IE-TDD-EL3313/Proyecto_1/docs/informe/informe_tecnico.md

# Informe técnico: Whack-a-Mole con lógica discreta y FPGA

## Resumen
Este proyecto presenta el diseño e implementación de un juego electrónico Whack-a-Mole mediante la integración de lógica discreta y una FPGA Nexys 4. El subsistema discreto, construido con integrados de la familia 74LS, utiliza un registro de desplazamiento con realimentación lineal (LFSR) para generar la posición pseudoaleatoria del topo y un decodificador 74LS138 para representarla en uno de ocho LEDs. La FPGA concentra el control del juego mediante una arquitectura modular desarrollada en SystemVerilog, incluyendo sincronización y antirrebote de ocho botones externos, temporización de los turnos, evaluación de golpes, dificultad progresiva, conteo de aciertos y fallos, control de vidas y visualización en displays de siete segmentos.
Aunque el planteamiento original especificaba una comunicación UART 8N1, las dificultades encontradas durante su integración llevaron a implementar temporalmente un enlace paralelo de tres bits para transmitir la posición. Las diferencias de voltaje entre ambos subsistemas se resolvieron mediante divisores resistivos y un transistor 2N2222 para la señal de solicitud. Los módulos de la FPGA fueron verificados mediante testbenches autoverificables, y la integración superó las pruebas de aciertos, fallos, timeout, dificultad, fin de partida y reinicio automático. La implementación demostró el funcionamiento general del juego, aunque se identificaron limitaciones en el LFSR discreto y en la confiabilidad de algunas solicitudes.

---

## 1. Introducción

### 1.1 Contexto

Whack-a-Mole es un juego en el que se activa aleatoriamente una de varias posiciones y el jugador debe presionar el botón correspondiente antes de que finalice un tiempo determinado. El proyecto solicita dividir el sistema en dos subsistemas: un circuito discreto encargado de generar y mostrar la posición pseudoaleatoria del topo, y una FPGA responsable del control de turnos, botones, puntajes, dificultad y visualización. La comunicación especificada originalmente entre ambos subsistemas corresponde a un enlace UART asíncrono 8N1.

### 1.2 Solución desarrollada

El circuito discreto utiliza un LFSR para generar una posición de tres bits y un 74LS138 para activar uno de ocho LEDs. La FPGA recibe la posición, solicita nuevos topos, filtra las señales de ocho botones externos y controla el juego mediante una máquina de estados. Además, implementa la ventana temporal, dificultad progresiva, conteo de aciertos y fallos, tres oportunidades consecutivas, estado de fin de partida y cuatro displays de siete segmentos.

### 1.3 Alcance y limitaciones
Se implementaron y verificaron completamente los módulos principales de control de la FPGA mediante testbenches autoverificables. Debido a problemas de estabilidad durante la integración UART, la posición se transmitió finalmente mediante el bus paralelo `Q[2:0]`. Esta modificación permitió obtener una integración funcional, pero no cumple el enlace serial solicitado originalmente. También se observaron bloqueos en ciertas posiciones del LFSR, especialmente en el estado 000, que requiere una semilla no nula o una corrección de la lógica de realimentación. Asimismo, algunas solicitudes no fueron reconocidas correctamente por el circuito discreto, por lo que se incorporaron mecanismos de diagnóstico y control de pulsos.

---

## 2. Objetivos

### 2.1 Objetivo general

Diseñar e implementar un juego Whack-a-Mole utilizando un subsistema de lógica discreta para generar la posición pseudoaleatoria y una FPGA Nexys 4 para controlar la dinámica del juego, las entradas del usuario, la temporización y la visualización de resultados.

### 2.2 Objetivos específicos

- Diseñar un generador pseudoaleatorio mediante un LFSR discreto.
- Decodificar la posición mediante un 74LS138.
- Generar una posición ante cada solicitud de la FPGA.
- Implementar ocho botones externos con sincronización y antirrebote.
- Controlar el juego mediante una máquina de estados finitos.
- Implementar dificultad progresiva entre 1500 ms y 500 ms.
- Contabilizar aciertos, fallos acumulados y fallos consecutivos.
- Mostrar los resultados en cuatro displays de siete segmentos.
- Implementar el estado de fin de partida y el reinicio.
- Verificar los módulos mediante testbenches autoverificables.
- Comparar los resultados teóricos, simulados y experimentales.

---

## 3. Especificaciones

### 3.1 Requisitos funcionales

La siguiente tabla compara los requisitos establecidos en el instructivo con la implementación final del sistema.

| Requisito | Valor especificado | Implementación final |
|---|---:|---|
| Posiciones del topo | 8 | Ocho posiciones codificadas mediante `Q[2:0]` y representadas en los LEDs `LD0–LD7` |
| Botones externos | 8 | Ocho pulsadores conectados al Pmod JB, sincronizados y filtrados contra rebotes |
| Tiempo inicial | 1500 ms | Ventana inicial de 1500 ms controlada por `turn_window_timer` |
| Reducción por acierto | 100 ms | Reducción de 100 ms después de cada acierto |
| Tiempo mínimo | 500 ms | Saturación de la ventana temporal en 500 ms |
| Fallos consecutivos | 3 | La partida termina después del tercer fallo consecutivo |
| Game over | 2000 ms | Estado de fin de partida durante 2000 ms, seguido de reinicio automático |
| Aciertos | 00–99 | Contador acumulado saturado en 99 y mostrado en dos dígitos |
| Fallos acumulados | 00–99 | Contador acumulado saturado en 99 y mostrado en dos dígitos |
| Reloj de la FPGA | 100 MHz | Reloj principal de 100 MHz de la Nexys 4 |
| Base temporal | 1 ms | Clock enable de un ciclo cada 100 000 ciclos de reloj |
| Indicador de estado | Partida activa/finalizada | `LD15` fijo durante la partida y parpadeante durante game over |
| Comunicación requerida | UART asíncrono 8N1 | Sustituida durante la integración por un enlace paralelo `Q[2:0]` |
| Solicitud de nuevo topo | Un pulso por turno | Pulso de 500 ms enviado por JA4 mediante un transistor 2N2222 |
| Reset general | Botón central | `BTNC` reinicia puntajes, fallos consecutivos, dificultad y secuencia de control |

La comunicación paralela fue utilizada debido a problemas de estabilidad encontrados durante la integración del enlace UART. Esta adaptación permitió verificar el funcionamiento del subsistema de control, pero representa una desviación respecto al protocolo exigido originalmente.

### 3.2 Requisitos eléctricos

El circuito discreto utiliza integrados de la familia 74LS alimentados con 5 V, mientras que las entradas y salidas Pmod de la Nexys 4 trabajan con lógica de 3.3 V. Por esta razón, fue necesario adaptar los niveles eléctricos entre ambos subsistemas.

- La lógica discreta se alimenta con una fuente regulada de 5 V.
- La FPGA utiliza niveles lógicos LVCMOS de 3.3 V.
- La FPGA y la protoboard comparten una misma referencia de tierra.
- Las señales `Q0`, `Q1` y `Q2` pasan por divisores resistivos antes de ingresar a JA1, JA2 y JA3.
- El voltaje aplicado a una entrada Pmod no debe superar 3.3 V.
- La señal discreta `SOLICITUD_TOPO` posee una resistencia pull-up de 10 kΩ hacia 5 V.
- `SOLICITUD_TOPO` es una señal activa en bajo.
- La salida JA4 no se conecta directamente al nodo de 5 V.
- Se utiliza un transistor NPN 2N2222 para aislar los niveles eléctricos e invertir la solicitud.

La conexión utilizada para generar la solicitud es:

```text
JA4 de la FPGA ── resistencia de 10 kΩ ── base del 2N2222
GND común ─────────────────────────────── emisor del 2N2222
SOLICITUD_TOPO ────────────────────────── colector del 2N2222
5 V ── resistencia pull-up de 10 kΩ ───── SOLICITUD_TOPO
```
---

## 4. Fundamentación teórica

### 4.1 Lógica combinacional y secuencial

Los sistemas digitales se construyen mediante lógica combinacional y lógica secuencial. En la lógica combinacional, las salidas dependen únicamente de las entradas presentes. Algunos ejemplos son las compuertas AND, OR, NOT y XOR, así como los multiplexores, comparadores y decodificadores.

En la lógica secuencial, las salidas también dependen del estado almacenado previamente. Los flip-flops permiten almacenar un bit, mientras que varios flip-flops conectados forman registros y contadores. En este proyecto se utilizan registros para almacenar los estados de la FSM, posiciones, puntajes, tiempos y niveles anteriores de los botones.

Toda la lógica secuencial de la FPGA trabaja con el reloj principal de 100 MHz de la Nexys 4. Para implementar eventos lentos no se generan relojes adicionales, sino una señal `ce_1ms` que habilita los registros una vez por milisegundo. Este enfoque mantiene un único dominio de reloj y facilita el análisis temporal.

El reset utilizado en los módulos es síncrono, ya que se evalúa dentro de bloques:

```systemverilog
always_ff @(posedge clk)
```

Los registros utilizan asignaciones no bloqueantes (`<=`), las cuales representan que todos los flip-flops actualizan sus salidas simultáneamente después del flanco activo del reloj. Por otra parte, la lógica combinacional se describe mediante `always_comb` y debe asignar valores en todos los caminos posibles para evitar la inferencia de latches no intencionados.

---

### 4.2 Linear Feedback Shift Register (LFSR)

Un Linear Feedback Shift Register es un registro de desplazamiento cuya entrada se calcula mediante una combinación XOR de algunos de sus bits internos. Los bits utilizados para calcular la realimentación reciben el nombre de *taps*.

En cada pulso de reloj, el contenido del registro se desplaza y el bit calculado mediante XOR se introduce en uno de sus extremos. Si se selecciona un polinomio primitivo, un LFSR de \(n\) bits puede producir una secuencia de periodo máximo:

\[
T_{\text{máximo}} = 2^n-1
\]

Para un LFSR de tres bits:

\[
T_{\text{máximo}} = 2^3-1 = 7
\]

Esto significa que un LFSR lineal convencional de tres bits puede recorrer como máximo siete estados no nulos antes de repetir la secuencia.

#### Polinomio utilizado

> **Importante:** sustituir esta expresión si los taps físicos utilizados por el equipo son diferentes.

Para una realimentación formada por `Q2 XOR Q1`, el polinomio puede representarse como:

\[
P(x)=x^3+x^2+1
\]

La ecuación de realimentación correspondiente es:

\[
f = Q_2 \oplus Q_1
\]

Suponiendo que el desplazamiento se realiza como:

```text
Q2_siguiente = Q1
Q1_siguiente = Q0
Q0_siguiente = Q2 XOR Q1
```

y que la semilla inicial es `001`, se obtiene la siguiente secuencia:

| Pulso | Estado actual | Realimentación `Q2 XOR Q1` | Estado siguiente | LED |
|---:|:---:|:---:|:---:|:---:|
| 0 | `001` | `0` | `010` | LED1 |
| 1 | `010` | `1` | `101` | LED2 |
| 2 | `101` | `1` | `011` | LED5 |
| 3 | `011` | `1` | `111` | LED3 |
| 4 | `111` | `0` | `110` | LED7 |
| 5 | `110` | `0` | `100` | LED6 |
| 6 | `100` | `1` | `001` | LED4 |

La tabla debe compararse con la secuencia medida en la protoboard. Si el orden real de desplazamiento o los taps son diferentes, debe modificarse para representar el circuito construido.

#### Estado absorbente `000`

El estado `000` es un estado prohibido para un LFSR basado únicamente en XOR. Si todos los bits son cero, la realimentación también será cero:

\[
0 \oplus 0 = 0
\]

Después del desplazamiento, el estado siguiente vuelve a ser `000`. Por lo tanto, el sistema queda bloqueado y no puede salir de ese estado mediante pulsos normales de reloj.

```text
Estado actual:    000
Realimentación:     0
Estado siguiente: 000
```

Por esta razón se utiliza un reset que carga una semilla diferente de cero, como `001`. Sin embargo, un LFSR de tres bits continúa teniendo solamente siete estados útiles. Para observar las ocho combinaciones en el 74LS138 sin utilizar un estado interno bloqueado, una alternativa consiste en implementar un LFSR de cuatro bits y utilizar tres de sus bits como posición visible.

---

### 4.3 Decodificador 74LS138

El 74LS138 es un decodificador de tres entradas y ocho salidas. Las entradas binarias A, B y C seleccionan una de las ocho salidas disponibles. El integrado también posee entradas de habilitación que deben colocarse en los niveles apropiados para activar su funcionamiento.

Las salidas del 74LS138 son activas en bajo. Esto significa que la salida seleccionada toma un valor cercano a 0 V, mientras que las demás permanecen en nivel alto. Los LEDs deben conectarse considerando que el integrado absorbe corriente cuando selecciona una posición.

| Q2 | Q1 | Q0 | Salida activa | Posición |
|:---:|:---:|:---:|---|---|
| 0 | 0 | 0 | Y0 | LED0 |
| 0 | 0 | 1 | Y1 | LED1 |
| 0 | 1 | 0 | Y2 | LED2 |
| 0 | 1 | 1 | Y3 | LED3 |
| 1 | 0 | 0 | Y4 | LED4 |
| 1 | 0 | 1 | Y5 | LED5 |
| 1 | 1 | 0 | Y6 | LED6 |
| 1 | 1 | 1 | Y7 | LED7 |

De esta manera, la palabra de tres bits generada por el LFSR se convierte en una representación one-hot, en la que solamente uno de los ocho LEDs se encuentra activo.

---

### 4.4 UART asíncrono

UART es un protocolo de comunicación serial asíncrono. Los dispositivos transmisor y receptor no comparten una señal de reloj, por lo que ambos deben utilizar una velocidad previamente acordada, denominada *baud rate*.

El formato solicitado para el proyecto fue UART 8N1:

- Un bit de inicio en nivel bajo.
- Ocho bits de datos.
- Sin bit de paridad.
- Un bit de parada en nivel alto.
- Transmisión del bit menos significativo primero.

```text
Reposo | START | D0 | D1 | D2 | D3 | D4 | D5 | D6 | D7 | STOP
   1   |   0   |             8 bits              |  1
```

La cantidad de ciclos del reloj de la FPGA contenidos en cada bit se calcula mediante:

\[
CLKS\_PER\_BIT =
\frac{CLK\_FREQ}{BAUD\_RATE}
\]

Para un reloj de 100 MHz y una velocidad de 2400 baudios:

\[
CLKS\_PER\_BIT =
\frac{100\,000\,000}{2400}
\approx 41666
\]

El receptor espera aproximadamente medio periodo después de detectar el bit de inicio. Esto permite comprobar el inicio cerca del centro del bit, donde la señal presenta mayor estabilidad. Posteriormente, cada bit de datos se muestrea una vez por periodo UART.

#### Módulo `uart_synchronizer`

La entrada UART proviene de un circuito con un reloj independiente, por lo que es asíncrona respecto al reloj de la FPGA. El módulo `uart_synchronizer` utiliza dos flip-flops en cascada:

```systemverilog
serial_meta <= serial_async;
serial_sync <= serial_meta;
```

La primera etapa puede experimentar metastabilidad. La segunda reduce la probabilidad de que ese estado se propague hacia la lógica del receptor. Después del reset, ambas etapas se inicializan en uno, correspondiente al estado de reposo de UART.

#### Módulo `uart_rx`

El módulo `uart_rx` implementa el receptor mediante una FSM con cuatro estados:

| Estado | Función |
|---|---|
| `IDLE` | Espera que la línea cambie de uno a cero |
| `START` | Espera medio bit y confirma el inicio |
| `DATA` | Captura los ocho bits, comenzando por D0 |
| `STOP` | Verifica el bit de parada y genera `data_valid` |

El parámetro `CLKS_PER_BIT` establece la cantidad de ciclos de 100 MHz por bit, mientras que `HALF_BIT` permite verificar el bit de inicio aproximadamente en su centro.

Los bits recibidos se almacenan mediante:

```systemverilog
rx_data[bit_index] <= serial_sync;
```

Al recibir correctamente el bit de parada, `data_valid` se activa durante un solo ciclo de reloj. Esto indica que `rx_data` contiene un byte completo y válido.

El receptor utiliza por defecto:

```systemverilog
CLK_FREQ  = 100_000_000
BAUD_RATE = 2400
```

Ambos valores son parametrizables.

#### Módulo `uart_test_led`

El módulo `uart_test_led` integra:

- Un sincronizador de dos etapas.
- Una instancia de `uart_rx`.
- Un decodificador de los tres bits menos significativos.
- Ocho LEDs de salida.

En esta prueba se configuró el receptor a 9600 baudios:

```systemverilog
uart_rx #(
    .CLK_FREQ  (100_000_000),
    .BAUD_RATE (9600)
)
```

Cuando `data_valid` se activa, los tres bits menos significativos se convierten a una representación one-hot:

```systemverilog
case (rx_data[2:0])
    3'd0: led <= 8'b00000001;
    3'd1: led <= 8'b00000010;
    3'd2: led <= 8'b00000100;
    3'd3: led <= 8'b00001000;
    3'd4: led <= 8'b00010000;
    3'd5: led <= 8'b00100000;
    3'd6: led <= 8'b01000000;
    3'd7: led <= 8'b10000000;
endcase
```

Esto permitió verificar que un byte UART podía transformarse en la posición correspondiente.

#### Resultado de simulación UART

La simulación integrada utilizó:

```text
Frecuencia de reloj: 100 MHz
Baud rate:           2400 baudios
Formato:             UART 8N1
CLKS_PER_BIT:        41666 ciclos
```

Durante la prueba se transmitieron los siguientes bytes:

| Byte transmitido | Bits menos significativos | Posición esperada | Resultado |
|---:|:---:|---:|---|
| `0x05` | `101` | 5 | Correcto |
| `0x03` | `011` | 3 | Correcto |
| `0x07` | `111` | 7 | Correcto |
| `0x00` | `000` | 0 | Correcto |

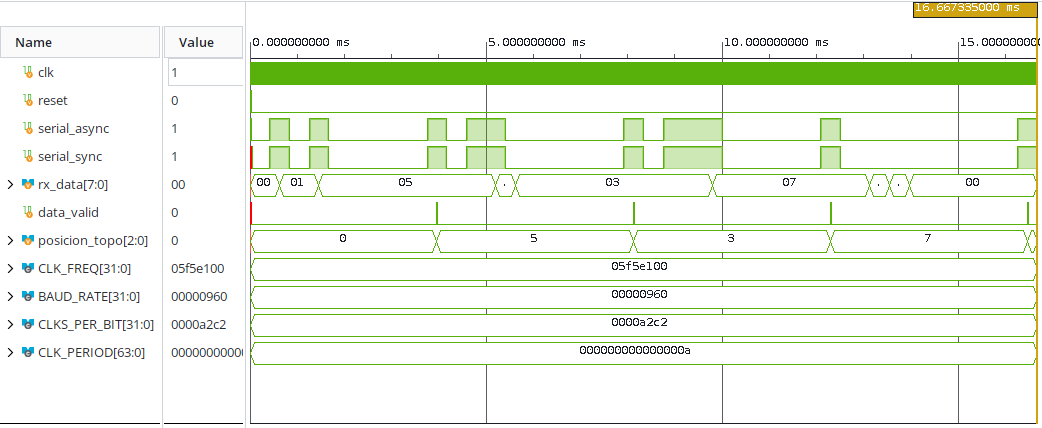
[picture p1: docs/informe/Imagenes/uart_integrado.png]
Simulación integrada del receptor UART


En la forma de onda se observa que `serial_async` contiene las tramas generadas por el testbench. La señal `serial_sync` reproduce la entrada después de atravesar el sincronizador de dos etapas.

Durante la recepción, `rx_data` cambia conforme se almacenan los bits. Por esta razón, su contenido solamente debe interpretarse cuando `data_valid` se activa. Después de cada trama válida, la posición registrada sigue la secuencia:

```text
0 → 5 → 3 → 7 → 0
```

El resultado demuestra que el sincronizador, la FSM del receptor, el registro de datos y la extracción de `rx_data[2:0]` funcionaron correctamente en simulación con señales UART ideales.

Durante la integración física se presentaron problemas de estabilidad relacionados con la generación discreta del baud rate y la comunicación entre dos relojes independientes. Por esta razón, la versión final utilizó temporalmente el bus paralelo `Q[2:0]`. La simulación se conserva como evidencia de que el receptor UART descrito en HDL funcionó bajo las condiciones temporales establecidas.

---

### 4.5 Comunicación paralela implementada

La integración final transmite la posición mediante tres señales independientes:

```text
Q0 → JA1
Q1 → JA2
Q2 → JA3
```

Estas señales representan directamente un valor binario entre cero y siete. Debido a que provienen de un circuito discreto de 5 V, se utilizan divisores resistivos para reducir su nivel antes de conectarlas a la FPGA.

Dentro de la FPGA, `Q[2:0]` atraviesa un sincronizador de dos etapas. Posteriormente, el módulo `parallel_position_receiver` exige que la palabra permanezca estable durante un tiempo configurable antes de aceptarla.

La salida `position_valid` se activa durante un ciclo cuando se acepta la primera posición o cuando se detecta una posición distinta de la anterior.

Las principales ventajas del enlace paralelo son:

- Menor complejidad de integración.
- No requiere recuperación de baud rate.
- Permite observar directamente la posición.
- Facilitó la verificación del control del juego.

Sus principales limitaciones son:

- Utiliza tres líneas en lugar de una.
- No corresponde al protocolo UART exigido.
- No contiene bits de inicio o parada.
- No diferencia dos recepciones consecutivas con el mismo valor sin una señal adicional de dato válido.
- La coherencia del bus depende del filtro de estabilidad.

---

### 4.6 Metastabilidad

La metastabilidad puede ocurrir cuando una entrada cambia muy cerca del flanco activo del reloj. En esta condición, un flip-flop puede tardar un tiempo indeterminado en establecer un cero o un uno válido.

Los botones, la entrada UART y las señales `Q0`, `Q1` y `Q2` son asíncronas respecto al reloj de 100 MHz. Para reducir el riesgo se utilizan dos flip-flops en cascada:

```text
Entrada asíncrona → primera etapa → segunda etapa → lógica interna
```

El sincronizador no elimina matemáticamente la metastabilidad, pero aumenta significativamente el tiempo disponible para que la primera etapa se estabilice antes de que la señal sea utilizada por el resto del diseño.

Para el bus paralelo, la sincronización se complementa con una validación temporal. Esto evita aceptar inmediatamente palabras transitorias causadas por diferencias en el tiempo de propagación de los tres bits.

---

### 4.7 Rebote de botones

Los contactos mecánicos de un pulsador no cambian una sola vez entre cero y uno. Durante algunos milisegundos pueden producir varias transiciones rápidas conocidas como rebote.

Sin un filtro, una sola pulsación podría interpretarse como múltiples golpes. El diseño realiza primero la sincronización de cada botón y después muestrea su nivel cada milisegundo.

Un nuevo estado solamente se acepta si permanece estable durante 10 ms consecutivos. Cuando el nivel filtrado cambia de cero a uno, se genera un pulso de un ciclo:

```systemverilog
buttons_pulse = buttons_level & ~previous_level;
```

`buttons_level` permanece alto mientras el botón está presionado, mientras que `buttons_pulse` dura únicamente un ciclo de 100 MHz. Los contadores y la FSM utilizan el pulso para registrar un solo evento por pulsación.

---

### 4.8 Máquinas de estados

Una máquina de estados finitos controla el comportamiento de un sistema secuencial mediante un conjunto definido de estados y condiciones de transición.

La FSM principal utiliza una arquitectura Moore, porque sus salidas dependen principalmente del estado actual. El diseño se divide en tres partes:

1. Registro del estado actual.
2. Lógica combinacional de estado siguiente.
3. Lógica combinacional de salidas.

El registro se actualiza mediante:

```systemverilog
always_ff @(posedge clk)
```

La lógica de transición utiliza un valor predeterminado:

```systemverilog
next_state = current_state;
```

La lógica de salidas también asigna valores por defecto antes del bloque `case`. Esto garantiza que todas las señales tengan un valor en cualquier condición y evita inferir latches.

Los estados principales controlan:

- Solicitud de una nueva posición.
- Espera de una posición válida.
- Inicio de la ventana temporal.
- Evaluación del golpe.
- Resolución de acierto o fallo.
- Inicio y espera de game over.
- Reinicio automático.

---

### 4.9 Displays de siete segmentos

La Nexys 4 posee displays cuyos segmentos y ánodos son activos en bajo. Un segmento se enciende al colocar cero en su señal, y un dígito se habilita al colocar cero en su ánodo.

El diseño utiliza multiplexación temporal. Solamente un dígito se encuentra activo en cada instante, pero el barrido ocurre suficientemente rápido para que el observador perciba los cuatro dígitos encendidos simultáneamente.

El índice de barrido cambia cada 1 ms:

```text
AN0 → unidades de aciertos
AN1 → decenas de aciertos
AN2 → unidades de fallos
AN3 → decenas de fallos
```

Como existen cuatro dígitos, cada uno se actualiza una vez cada 4 ms.

Los valores binarios de los contadores se convierten a decimal mediante división y módulo por diez:

```systemverilog
unidades = valor % 10;
decenas  = valor / 10;
```

---

## 5. Metodología

### 5.1 Diseño modular

El sistema se desarrolló mediante una arquitectura modular, dividiendo el funcionamiento general en bloques con responsabilidades específicas. Esta organización permitió diseñar, simular y verificar cada parte de manera independiente antes de realizar la integración completa.

Los principales bloques desarrollados fueron:

- Generación de señales de habilitación temporal.
- Sincronización de entradas externas.
- Filtrado y detección de pulsos de los botones.
- Recepción paralela de la posición del topo.
- Generación de la señal `SOLICITUD_TOPO`.
- Evaluación de aciertos y fallos.
- Temporización de cada turno.
- Control de dificultad.
- Conteo de aciertos, fallos acumulados y fallos consecutivos.
- Control de finalización de la partida.
- Máquina de estados principal.
- Control multiplexado de los displays de siete segmentos.
- Indicadores visuales mediante LED.
- Módulo superior de integración.

La modularización facilitó la localización de errores, la reutilización de componentes y la creación de testbenches específicos. Además, permitió comprobar las interfaces entre módulos mediante señales claramente definidas, reduciendo la complejidad del proceso de integración.

### 5.2 Flujo de desarrollo

El desarrollo se realizó de forma incremental mediante las siguientes etapas:

1. **Análisis de requisitos:** se estudiaron las especificaciones del instructivo, incluyendo número de posiciones, tiempos, dificultad, puntuación, condiciones de finalización y comunicación entre subsistemas.

2. **Diseño del diagrama de bloques:** se definieron los subsistemas de lógica discreta y FPGA, junto con las señales necesarias para su comunicación.

3. **Desarrollo de módulos:** cada función se implementó en un módulo independiente de SystemVerilog, utilizando parámetros cuando era necesario ajustar tiempos durante las simulaciones.

4. **Creación de testbenches:** se elaboraron bancos de prueba para verificar individualmente el comportamiento de los módulos y sus condiciones límite.

5. **Integración:** los módulos verificados se conectaron dentro de `whack_a_mole_top`, que representa el nivel superior del sistema.

6. **Simulación integral:** se comprobó el funcionamiento completo del juego, incluyendo aciertos, fallos, reducción de tiempo, tres fallos consecutivos y finalización de la partida.

7. **Síntesis:** se sintetizó el diseño para comprobar que el código fuera implementable en la FPGA y que no existieran errores de descripción de hardware.

8. **Implementación:** se ejecutaron las etapas de optimización, colocación y enrutamiento para la FPGA Artix-7 de la tarjeta Nexys 4.

9. **Generación del bitstream:** después de completar correctamente la implementación, se generó el archivo de configuración de la FPGA.

10. **Prueba física:** se conectaron la tarjeta Nexys 4, la protoboard, los botones externos, el bus de posición y el circuito de solicitud. Se verificó el comportamiento mediante LED, displays y mediciones eléctricas.

11. **Diagnóstico y correcciones:** los problemas encontrados se analizaron utilizando simulaciones, LED de depuración y mediciones con multímetro. Entre las correcciones realizadas estuvieron la adaptación de niveles eléctricos, el antirrebote de botones y el ajuste de la señal `SOLICITUD_TOPO`.

Este procedimiento permitió avanzar desde pruebas unitarias hasta la validación física del sistema completo, conservando evidencia de los resultados obtenidos en cada etapa.

### 5.3 Herramientas

Durante el desarrollo se utilizaron las siguientes herramientas:

| Herramienta o componente | Uso dentro del proyecto |
| --- | --- |
| Vivado 2026.1 | Creación del proyecto, simulación, síntesis, implementación, generación del bitstream y programación de la FPGA. |
| SystemVerilog | Descripción de los módulos digitales y elaboración de los testbenches. |
| XSim | Simulación funcional y verificación de señales internas. |
| Git | Control de versiones y registro incremental de los cambios realizados. |
| GitHub | Almacenamiento remoto del repositorio y colaboración entre integrantes. |
| Nexys 4 | Plataforma FPGA utilizada para implementar el control digital del juego. |
| Protoboard | Construcción y conexión del subsistema de lógica discreta. |
| Integrados 74LS | Implementación de registros, compuertas y decodificación en la sección discreta. |
| 74LS138 | Decodificación de la posición binaria para activar uno de los ocho LED del topo. |
| Multímetro | Medición de niveles de tensión y diagnóstico de conexiones. |
| Transistor 2N2222 | Adaptación, aislamiento e inversión de la señal `SOLICITUD_TOPO`. |
| Resistencias | Adaptación de niveles lógicos, polarización del transistor y generación de señales de pull-up o pull-down. |
| LED y pulsadores | Representación de las posiciones del topo y generación de entradas del jugador. |

La combinación de simulación, control de versiones y medición física permitió comparar el comportamiento esperado con el observado en el prototipo. Esto fue especialmente importante para distinguir errores de lógica digital, problemas de temporización y fallos de conexión eléctrica.

---

## 6. Arquitectura general

### 6.1 Diagrama de bloques

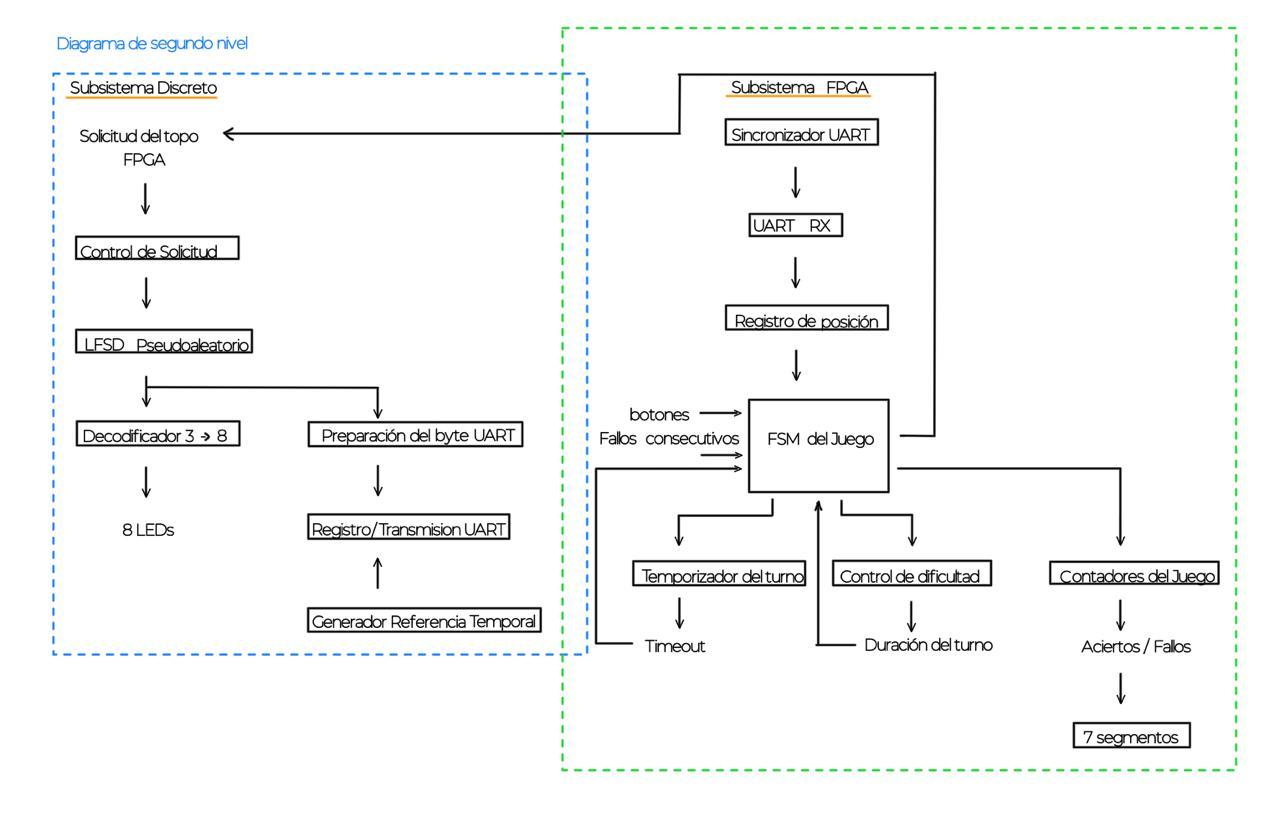
[picture p2: docs/informe/Imagenes/Diagrama_bloques.jpeg]
Diagrama general de bloques


**Figura 1.** Diagrama de segundo nivel de la arquitectura original del proyecto.

El sistema se divide en dos subsistemas principales: la sección de lógica discreta y la sección implementada en la FPGA. El flujo de control comienza en la FPGA, que genera la señal `SOLICITUD_TOPO` para indicar que se requiere una nueva posición. Esta señal se adapta eléctricamente mediante un transistor 2N2222 antes de ingresar al circuito discreto.

En el subsistema discreto, el bloque de control de solicitud genera el pulso requerido para desplazar el LFSR. El LFSR produce una posición pseudoaleatoria de tres bits, representada por `Q[2:0]`. Esta posición se entrega al decodificador 74LS138, el cual activa una de sus ocho salidas y enciende el LED correspondiente.

El diagrama muestra también la ruta UART propuesta originalmente. En esta arquitectura, la posición debía prepararse como un byte, transmitirse de manera serial y ser recibida por los bloques `Sincronizador UART`, `UART_RX` y `Registro de posición` de la FPGA. Estos módulos fueron desarrollados y verificados mediante simulación; sin embargo, la comunicación UART no funcionó de manera estable durante la integración física.

Por esta razón, en la implementación final la ruta UART fue sustituida por una comunicación paralela directa. Las salidas `Q0`, `Q1` y `Q2` del LFSR se conectaron a tres entradas Pmod de la FPGA mediante adaptación de nivel de 5 V a aproximadamente 3.3 V. Dentro de la FPGA, estas señales pasan por sincronizadores de dos etapas y por un receptor que valida su estabilidad antes de entregar la posición al control del juego.

> **Nota:** el diagrama representa la arquitectura originalmente propuesta con comunicación UART. En la implementación final, los bloques de preparación, transmisión, sincronización y recepción UART fueron reemplazados funcionalmente por el bus paralelo `Q[2:0]` y el módulo `parallel_position_receiver`.

La máquina de estados principal, implementada en `game_controller_fsm`, coordina el desarrollo de la partida. Este bloque recibe la posición validada, los pulsos de los botones, el resultado de la evaluación de cada jugada, la señal de tiempo agotado y la cantidad de fallos consecutivos. A partir de estas entradas controla la solicitud de nuevas posiciones, la apertura de cada turno, la actualización de los contadores y la finalización de la partida.

El temporizador del turno controla el intervalo durante el cual se acepta una respuesta del jugador. Su duración proviene del controlador de dificultad, el cual inicia en 1500 ms, reduce 100 ms después de cada acierto y mantiene un límite mínimo de 500 ms.

Los contadores del juego registran los aciertos y los fallos acumulados. De forma independiente, el bloque de fallos consecutivos determina cuándo se alcanzan tres errores seguidos. Cuando esto sucede, la FSM entra en el estado de finalización de la partida. Los valores de aciertos y fallos se convierten a decimal y se presentan en cuatro dígitos del display de siete segmentos.

El flujo principal de señales puede resumirse de la siguiente forma:

```text
FPGA: SOLICITUD_TOPO
          |
          v
Adaptación con 2N2222
          |
          v
Control de solicitud -> LFSR -> Q[2:0] -> 74LS138 -> LED del topo
                                  |
                                  v
                      Adaptación de nivel
                                  |
                                  v
                    Receptor paralelo FPGA
                                  |
                                  v
Botones -> Antirrebote -> Evaluador -> FSM principal
                                      |
             +------------------------+----------------------+
             |                        |                      |
             v                        v                      v
     Temporizador del turno   Control de dificultad   Contadores
                                                            |
                                                            v
                                                Displays de 7 segmentos
```

### 6.2 Flujo de una jugada

El funcionamiento de una jugada se desarrolla mediante la siguiente secuencia:

1. La máquina de estados determina que se necesita una nueva posición y activa internamente la orden de solicitud.

2. El módulo `mole_request_generator` convierte la orden interna en la señal física `SOLICITUD_TOPO`.

3. La salida de la FPGA controla la base de un transistor 2N2222. El transistor aísla los niveles de 3.3 V y 5 V e invierte la señal antes de entregarla al circuito discreto.

4. El control de solicitud del circuito discreto genera el pulso que hace avanzar el LFSR.

5. El LFSR actualiza su estado de tres bits y produce una nueva posición pseudoaleatoria mediante `Q[2:0]`.

6. El decodificador 74LS138 interpreta la posición y activa una de sus ocho salidas, encendiendo el LED que representa al topo.

7. Simultáneamente, `Q0`, `Q1` y `Q2` ingresan a la FPGA mediante tres entradas Pmod protegidas con adaptación de nivel.

8. El módulo `parallel_position_receiver` sincroniza las entradas con el reloj de 100 MHz y verifica que la posición permanezca estable antes de declararla válida.

9. Una vez recibida la posición válida, la FSM abre la ventana temporal del turno mediante `turn_window_timer`.

10. Durante la ventana activa, el sistema espera que el jugador presione uno de los ocho botones externos. Cada botón pasa primero por sincronización y antirrebote para generar un único pulso limpio.

11. El módulo `game_hit_evaluator` compara el botón presionado con la posición activa:

    - Si el botón corresponde al topo encendido, genera un acierto.
    - Si corresponde a otra posición, genera un fallo.
    - Si no se presiona ningún botón antes de finalizar la ventana, el timeout se registra como fallo.

12. Después de resolver la jugada se actualizan los datos del juego:

    - Un acierto incrementa el contador de aciertos.
    - Un fallo incrementa el contador de fallos acumulados.
    - Un acierto reinicia el contador de fallos consecutivos.
    - Un fallo incrementa el contador de fallos consecutivos.
    - Un acierto reduce en 100 ms la duración del siguiente turno, hasta alcanzar el mínimo de 500 ms.

13. Los contadores actualizados se muestran en cuatro dígitos del display:

    - Dos dígitos para los aciertos.
    - Dos dígitos para los fallos acumulados.

14. Si todavía no se han alcanzado tres fallos consecutivos, la FSM solicita una nueva posición y comienza otra jugada.

15. Cuando se alcanzan tres fallos consecutivos, la FSM entra en el estado de finalización de la partida. En la implementación final, el sistema permanece en este estado hasta que el usuario activa el reset general.

La secuencia puede representarse de forma resumida como:

```text
Solicitar posición
        |
        v
Actualizar LFSR y encender topo
        |
        v
Recibir y validar Q[2:0]
        |
        v
Abrir ventana temporal
        |
        v
¿Se presionó un botón?
     /             \
   Sí               No
   |                |
   v                v
Comparar         Timeout
posición            |
   |                |
   +-------+--------+
           |
           v
Registrar acierto o fallo
           |
           v
Actualizar puntaje y dificultad
           |
           v
¿Hay 3 fallos consecutivos?
       /          \
     No            Sí
     |              |
     v              v
Nueva posición   Fin de partida
``` 

---

## 7. Subsistema FPGA

### 7.1 `ce_1ms_generator`

El módulo `ce_1ms_generator` produce una señal de habilitación de un ciclo de reloj cada milisegundo. Esta señal, denominada `ce_1ms`, funciona como base temporal para los módulos que requieren medir intervalos en milisegundos, como el antirrebote de los botones, el temporizador del turno, el generador de solicitudes y el temporizador de finalización de la partida.

El módulo no genera un reloj nuevo. Todos los elementos secuenciales continúan trabajando con el reloj principal de 100 MHz y solamente realizan determinadas operaciones cuando `ce_1ms` se encuentra en nivel alto. Esta decisión evita introducir dominios de reloj adicionales y reduce los posibles problemas de sincronización.

#### Interfaz del módulo

| Señal | Dirección | Descripción |
| ----- | :---: | --- |
| `clk` | Entrada | Reloj principal de la FPGA, con una frecuencia de 100 MHz. |
| `reset` | Entrada | Reinicio síncrono activo en alto. Limpia el contador y desactiva `ce_1ms`. |
| `ce_1ms` | Salida | Pulso de habilitación de un ciclo de reloj generado cada milisegundo. |

El módulo posee el siguiente parámetro:

| Parámetro | Valor predeterminado | Descripción |
| --- | ---: | --- |
| `CLK_FREQ_HZ` | `100_000_000` | Frecuencia del reloj principal expresada en hercios. |

#### Cálculo del divisor

La cantidad de ciclos de reloj contenidos en un milisegundo se calcula mediante:

```text
CYCLES_PER_MS = CLK_FREQ_HZ / 1000
```

Para el reloj de 100 MHz de la Nexys 4:

```text
CYCLES_PER_MS = 100 000 000 / 1000
              = 100 000 ciclos
```

El periodo del reloj principal es:

```text
Tclk = 1 / 100 000 000
     = 10 ns
```

Por lo tanto, el intervalo contado es:

```text
100 000 × 10 ns = 1 000 000 ns = 1 ms
```

El ancho mínimo del contador se determina con:

```systemverilog
COUNTER_WIDTH = $clog2(CYCLES_PER_MS);
```

Para `CYCLES_PER_MS = 100000`:

```text
COUNTER_WIDTH = ceil(log2(100000)) = 17 bits
```

Esto se debe a que:

```text
2^16 = 65 536 < 100 000
2^17 = 131 072 ≥ 100 000
```

En el código se utiliza una condición adicional para garantizar que el contador tenga al menos un bit cuando el módulo se configura con una frecuencia pequeña:

```systemverilog
localparam integer COUNTER_WIDTH =
    (CYCLES_PER_MS <= 1) ? 1 : $clog2(CYCLES_PER_MS);
```

#### Funcionamiento

El registro `cycle_counter` se incrementa en cada flanco ascendente de `clk`. La cuenta comienza en cero y finaliza cuando alcanza:

```text
CYCLES_PER_MS - 1 = 99 999
```

Cuando se alcanza este valor:

- `cycle_counter` regresa a cero.
- `ce_1ms` se activa durante un ciclo del reloj principal.
- En el siguiente ciclo, `ce_1ms` vuelve a cero.
- Comienza la cuenta del siguiente milisegundo.

El comportamiento puede representarse de la siguiente forma:

```text
Contador:  0, 1, 2, ... 99 998, 99 999, 0, 1, ...
ce_1ms:    0, 0, 0, ...      0,      1, 0, 0, ...
```

Aunque el pulso aparece cada milisegundo, su duración no es de 1 ms. Su duración corresponde a un único periodo del reloj de 100 MHz:

```text
Duración de ce_1ms = 10 ns
```

De esta manera, `ce_1ms` actúa como una habilitación periódica y no como una señal de reloj de 1 kHz.

#### Comportamiento del reset

El reset es síncrono, por lo que se evalúa únicamente durante el flanco ascendente de `clk`. Cuando `reset` está activo:

```systemverilog
cycle_counter <= '0;
ce_1ms        <= 1'b0;
```

Esto garantiza que el contador vuelva a su estado inicial y que no se genere un pulso de habilitación durante el reinicio.

#### Decisiones de diseño

Se decidió utilizar una señal de habilitación en lugar de dividir físicamente el reloj por las siguientes razones:

- Mantiene todo el diseño dentro de un único dominio de reloj.
- Evita utilizar una señal generada por lógica común como reloj.
- Simplifica el análisis temporal durante la síntesis e implementación.
- Reduce el riesgo de desfases, glitches y problemas de distribución del reloj.
- Permite reutilizar una misma base temporal en varios módulos.
- Facilita las simulaciones mediante la modificación del parámetro `CLK_FREQ_HZ`.

El parámetro de frecuencia también permite acelerar los testbenches. En simulación puede emplearse una frecuencia reducida para obtener un pulso equivalente a 1 ms utilizando pocos ciclos, sin modificar la lógica funcional del módulo.

#### Resumen de operación

```text
Reloj de 100 MHz
       |
       v
Contador de 0 a 99 999
       |
       v
Pulso ce_1ms durante un ciclo
       |
       v
Reinicio del contador y repetición
```

En consecuencia, `ce_1ms_generator` proporciona una referencia temporal común, síncrona y reutilizable para el resto del sistema.

### 7.2 `sync_2ff`

El módulo `sync_2ff` sincroniza señales externas que no están alineadas con el reloj de la FPGA. Se utiliza antes de procesar señales provenientes de los botones y del bus paralelo `Q[2:0]`.

Las entradas externas pueden cambiar en cualquier instante, incluso cerca de un flanco ascendente de `clk`. Si esto ocurre, el flip-flop que recibe la señal puede incumplir sus tiempos de establecimiento o retención y entrar temporalmente en metastabilidad.

#### Interfaz del módulo

| Señal | Dirección | Descripción |
| ----- | :---: | --- |
| `clk` | Entrada | Reloj principal de la FPGA. |
| `reset` | Entrada | Reset síncrono activo en alto. |
| `async_in` | Entrada | Vector de señales externas asíncronas. |
| `sync_out` | Salida | Vector sincronizado con el reloj de la FPGA. |

El módulo posee el siguiente parámetro:

| Parámetro | Valor predeterminado | Descripción |
| --- | ---: | --- |
| `WIDTH` | `1` | Cantidad de señales sincronizadas en paralelo. |

La parametrización permite utilizar el mismo módulo para una señal individual o para un vector. Por ejemplo, puede configurarse con `WIDTH = 8` para sincronizar los ocho botones externos.

#### Metastabilidad

La metastabilidad ocurre cuando una entrada cambia demasiado cerca del flanco de reloj. En esta condición, la salida del flip-flop puede tardar un tiempo indeterminado en establecerse en cero o uno.

El sincronizador utiliza dos registros conectados en serie:

```text
Señal asíncrona -> Primera etapa -> Segunda etapa -> Lógica del sistema
                    meta_stage       sync_out
```

La primera etapa, `meta_stage`, es la que recibe directamente la entrada asíncrona y puede entrar en metastabilidad. La segunda etapa recibe el valor de la primera un ciclo después, proporcionando tiempo adicional para que la señal se estabilice antes de ser utilizada por el resto del sistema.

Su operación está descrita mediante:

```systemverilog
meta_stage <= async_in;
sync_out   <= meta_stage;
```

Debido al uso de asignaciones no bloqueantes, `sync_out` recibe el valor anterior de `meta_stage`. Por tanto, Vivado infiere dos etapas reales de registros y no una conexión combinacional.

El sincronizador reduce considerablemente la probabilidad de que la metastabilidad se propague, pero no la elimina matemáticamente. Su objetivo es hacer que dicha probabilidad sea suficientemente pequeña para la operación normal del sistema.

#### Latencia

Una transición de `async_in` necesita normalmente dos flancos ascendentes para aparecer en `sync_out`:

```text
Flanco 1: meta_stage captura async_in
Flanco 2: sync_out captura meta_stage
```

Con un reloj de 100 MHz, cada periodo dura 10 ns. Por tanto, la latencia nominal introducida por las dos etapas es aproximadamente:

```text
Latencia nominal = 2 × 10 ns = 20 ns
```

Dependiendo del instante exacto en que cambie la señal externa respecto al reloj, la latencia observable puede variar aproximadamente entre uno y dos periodos antes de quedar disponible de forma sincronizada.

Esta latencia es despreciable en comparación con los tiempos humanos de los botones y con las ventanas del juego, medidas en milisegundos.

#### Comportamiento del reset

Cuando se activa `reset`, ambas etapas se limpian:

```systemverilog
meta_stage <= '0;
sync_out   <= '0;
```

Esto proporciona un estado inicial conocido y evita que el resto del sistema interprete una entrada activa durante el reinicio.

#### Consideraciones para buses de varios bits

El parámetro `WIDTH` permite sincronizar varios bits al mismo tiempo. Sin embargo, sincronizar cada bit de un bus mediante dos flip-flops no garantiza que todos representen exactamente la misma palabra durante una transición. Algunos bits pueden estabilizarse un ciclo antes que otros.

Por esta razón, en el bus `Q[2:0]` el sincronizador se complementa con una validación temporal en `parallel_position_receiver`. La posición solamente se acepta después de permanecer estable durante el intervalo requerido.

#### Decisiones de diseño

Se seleccionó un sincronizador de dos etapas porque:

- Reduce el riesgo de propagación de metastabilidad.
- Mantiene las señales dentro del dominio de reloj de 100 MHz.
- Es una estructura sencilla y ampliamente utilizada para entradas asíncronas.
- Puede reutilizarse con diferentes anchos mediante `WIDTH`.
- Introduce una latencia muy pequeña respecto a los tiempos del juego.

En resumen:

```text
Entrada asíncrona
        |
        v
Primera etapa: posible metastabilidad
        |
        v
Segunda etapa: señal sincronizada
        |
        v
Lógica interna de la FPGA
```

---

### 7.3 `button_debouncer`

El módulo `button_debouncer` elimina las transiciones falsas producidas por el rebote mecánico de un pulsador. Recibe una señal previamente sincronizada y solamente actualiza su salida cuando detecta un nuevo nivel estable durante un número determinado de milisegundos.

Un botón real no cambia instantáneamente entre cero y uno. Sus contactos pueden abrirse y cerrarse varias veces durante una sola pulsación:

```text
Señal ideal:  0 0 0 0 1 1 1 1 1
Señal real:   0 0 1 0 1 0 1 1 1
```

Sin antirrebote, estas transiciones podrían interpretarse como varias pulsaciones.

#### Interfaz del módulo

| Señal | Dirección | Descripción |
| ----- | :---: | --- |
| `clk` | Entrada | Reloj principal de 100 MHz. |
| `reset` | Entrada | Reset síncrono activo en alto. |
| `ce_1ms` | Entrada | Habilitación de un ciclo cada milisegundo. |
| `button_sync` | Entrada | Estado del botón después del sincronizador de dos etapas. |
| `button_level` | Salida | Nivel estable y filtrado del botón. |

El módulo incluye el siguiente parámetro:

| Parámetro | Valor predeterminado | Descripción |
| --- | ---: | --- |
| `DEBOUNCE_MS` | `10` | Cantidad de muestras consecutivas necesarias para aceptar un cambio. |

#### Validación temporal

El módulo observa `button_sync` únicamente cuando `ce_1ms` está activo. Por tanto, realiza una muestra cada milisegundo.

Si la entrada es igual al nivel filtrado actual, no existe un cambio pendiente y el contador regresa a cero:

```systemverilog
if (button_sync == button_level)
    stable_counter <= '0;
```

Si la entrada es diferente de `button_level`, el módulo comienza a contar muestras consecutivas. Cuando la diferencia se mantiene durante `DEBOUNCE_MS` muestras, el nuevo nivel se acepta:

```systemverilog
button_level   <= button_sync;
stable_counter <= '0;
```

Con el parámetro predeterminado:

```text
Periodo de muestreo = 1 ms
Muestras requeridas = 10
Tiempo de validación ≈ 10 ms
```

La secuencia puede representarse así:

```text
Tiempo:           0  1  2  3  4  5  6  7  8  9 ms
button_sync:      1  1  1  1  1  1  1  1  1  1
stable_counter:   1  2  3  4  5  6  7  8  9  valida
button_level:     0  0  0  0  0  0  0  0  0  1
```

Si durante el conteo la entrada regresa al nivel anterior, el cambio se considera rebote y el contador se reinicia:

```text
button_sync:      1  1  0
stable_counter:   1  2  0
button_level:     0  0  0
```

El mismo procedimiento se utiliza para validar tanto la pulsación como la liberación del botón.

#### Ancho del contador

El ancho del contador se calcula mediante:

```systemverilog
COUNTER_WIDTH =
    (DEBOUNCE_MS <= 1) ? 1 : $clog2(DEBOUNCE_MS);
```

Para `DEBOUNCE_MS = 10`:

```text
COUNTER_WIDTH = ceil(log2(10)) = 4 bits
```

Un contador de cuatro bits puede representar valores de 0 a 15, por lo que es suficiente para contar las muestras requeridas.

La condición especial garantiza un ancho mínimo de un bit cuando `DEBOUNCE_MS` se configura con un valor igual o inferior a uno.

#### Nivel filtrado y pulso de pulsación

La salida `button_level` representa el nivel estable del botón. No es por sí misma un pulso de un solo ciclo. Si el usuario mantiene presionado el botón, `button_level` permanece activo hasta que la liberación también sea validada.

La generación del pulso único se realiza posteriormente en `button_bank`, mediante la detección del flanco ascendente del nivel filtrado:

```text
button_sync -> button_debouncer -> button_level -> detección de flanco
                                                        |
                                                        v
                                            Pulso de un solo ciclo
```

Esta separación permite que `button_debouncer` se encargue únicamente de validar estabilidad, mientras que `button_bank` interpreta el cambio como una pulsación.

#### Comportamiento del reset

Durante el reset:

```systemverilog
stable_counter <= '0;
button_level   <= 1'b0;
```

Así, el sistema considera inicialmente que el botón se encuentra liberado. Después del reset, cualquier nivel alto debe permanecer estable durante el tiempo de antirrebote antes de ser aceptado.

#### Latencia introducida

El filtrado introduce una latencia intencional cercana a 10 ms. A esta se agrega la pequeña latencia del sincronizador de dos etapas.

De forma aproximada:

```text
Latencia total ≈ latencia de sincronización + validación temporal
               ≈ 20 ns + 10 ms
               ≈ 10 ms
```

Para una entrada humana, esta demora no es perceptible y evita que una pulsación genere múltiples eventos.

#### Decisiones de diseño

Las principales decisiones fueron:

- Sincronizar la entrada antes de aplicar el antirrebote.
- Muestrear cada 1 ms en lugar de contar directamente ciclos de 100 MHz.
- Exigir 10 muestras consecutivas iguales.
- Validar tanto la pulsación como la liberación.
- Mantener un único dominio de reloj.
- Parametrizar el tiempo mediante `DEBOUNCE_MS`.
- Separar el nivel filtrado de la generación del pulso único.

El comportamiento general puede resumirse así:

```text
Botón externo
      |
      v
Sincronizador de dos etapas
      |
      v
Muestreo cada 1 ms
      |
      v
¿Cambió durante 10 muestras consecutivas?
       /                          \
     No                            Sí
     |                              |
Reiniciar conteo             Aceptar nuevo nivel
```

En consecuencia, `button_debouncer` garantiza que el sistema responda una sola vez a una pulsación física estable y rechace las transiciones breves causadas por el rebote mecánico.

### 7.4 `button_bank`

El módulo `button_bank` se encarga de acondicionar las señales provenientes de los ocho pulsadores externos utilizados por el jugador.

Debido a que los pulsadores son dispositivos físicos externos a la FPGA, sus señales pueden cambiar de forma independiente al reloj interno y además pueden presentar rebote mecánico. Por esta razón, antes de utilizar las pulsaciones en la lógica del juego se realiza un proceso de sincronización, antirrebote y detección de pulsaciones válidas.

El módulo realiza tres funciones principales:

- Sincronizar las entradas de los ocho pulsadores con el reloj de la FPGA.
- Filtrar el rebote mecánico de cada pulsador.
- Generar un único pulso por cada nueva pulsación válida.

#### Entradas y salidas

| Señal | Tipo | Descripción |
|---|---|---|
| `clk` | Entrada | Reloj principal del sistema |
| `reset` | Entrada | Reinicio del módulo |
| `ce_1ms` | Entrada | Habilitación periódica utilizada como referencia temporal |
| `buttons_async[7:0]` | Entrada | Señales provenientes de los ocho pulsadores externos |
| `buttons_level[7:0]` | Salida | Estado estable y filtrado de cada pulsador |
| `buttons_pulse[7:0]` | Salida | Pulso generado cuando se detecta una nueva pulsación válida |

#### Funcionamiento

La primera etapa corresponde a la sincronización de las entradas. Los ocho bits de `buttons_async` pasan por un sincronizador de dos etapas antes de ser utilizados por la lógica interna.

Una vez sincronizadas, las señales son procesadas individualmente mediante bloques de antirrebote. Cada pulsador posee su propio filtro, lo que permite que los ocho botones sean evaluados de forma independiente.

En la implementación utilizada se estableció un tiempo de antirrebote de:

```text
DEBOUNCE_MS = 10 ms
```

Para aceptar un cambio, el nuevo estado del pulsador debe permanecer estable durante el intervalo configurado. Si la entrada cambia nuevamente antes de completar este tiempo, el cambio no se considera válido.

Después del proceso de antirrebote se obtiene `buttons_level`, que representa el estado estable de cada pulsador.

Sin embargo, para el funcionamiento del juego no se desea mantener una señal activa durante todo el tiempo que el jugador mantiene presionado el botón. Se requiere únicamente un evento por cada pulsación.

Para esto se almacena el nivel anterior de los botones y se realiza una detección de flanco ascendente mediante:

```systemverilog
assign buttons_pulse = buttons_level & ~previous_level;
```

De esta manera, cuando un botón cambia de `0` a `1`, se genera un único pulso en el bit correspondiente de `buttons_pulse`.

La secuencia de funcionamiento es:

1. Se recibe el estado físico de los ocho pulsadores.
2. Las señales son sincronizadas con el reloj de la FPGA.
3. Cada pulsador pasa por su propio filtro de antirrebote.
4. Se obtiene el estado estable mediante `buttons_level`.
5. Se compara el estado actual con el estado anterior.
6. Si se detecta un flanco ascendente, se genera un pulso en `buttons_pulse`.
7. La lógica del juego utiliza este pulso como una única acción del jugador.

#### Relación con el sistema

La salida `buttons_pulse` es utilizada por el módulo encargado de evaluar la jugada. Cada bit representa uno de los ocho botones asociados a las posibles posiciones del topo.

El uso de este módulo evita que el rebote mecánico o una pulsación prolongada produzcan múltiples aciertos o fallos.

Además, mantener el acondicionamiento de los botones en un módulo independiente permite separar el manejo de las entradas físicas de la lógica principal del juego.

### 7.5 `parallel_position_receiver`

El módulo `parallel_position_receiver` se encarga de recibir la posición generada por el subsistema de lógica discreta mediante un bus paralelo de tres bits.

La posición recibida no se utiliza directamente, debido a que las señales provenientes del circuito externo pueden cambiar de forma independiente al reloj de la FPGA. Por esta razón, el módulo realiza una sincronización del bus y posteriormente comprueba que el valor permanezca estable antes de aceptarlo como una nueva posición válida.

#### Entradas y salidas

| Señal | Tipo | Descripción |
|---|---|---|
| `clk` | Entrada | Reloj principal del sistema |
| `reset` | Entrada | Reinicio del módulo |
| `ce_1ms` | Entrada | Habilitación utilizada como referencia temporal |
| `position_async[2:0]` | Entrada | Posición proveniente del circuito discreto |
| `position[2:0]` | Salida | Posición sincronizada y validada |
| `position_valid` | Salida | Pulso que indica que existe una nueva posición válida |

#### Funcionamiento

El bus `position_async[2:0]` contiene la posición generada por el circuito discreto. Como estas señales provienen de un sistema externo a la FPGA, primero pasan por un sincronizador de dos etapas.

Después de la sincronización, el valor recibido se almacena temporalmente como una posición candidata.

El módulo utiliza `ce_1ms` para comprobar durante cuánto tiempo permanece estable este valor. En la implementación utilizada se estableció:

```text
POSITION_STABLE_MS = 2 ms
```

Por lo tanto, un cambio momentáneo en el bus no se acepta inmediatamente. La posición debe permanecer estable durante el intervalo configurado antes de ser utilizada por el resto del sistema.

Si el valor cambia antes de completar el tiempo de estabilidad, el conteo comienza nuevamente para la nueva posición.

Cuando el valor permanece estable durante el tiempo requerido, ocurren dos acciones:

- `position[2:0]` se actualiza con la nueva posición.
- `position_valid` genera un pulso indicando que el dato está disponible.

La secuencia de funcionamiento es:

1. Se recibe `position_async[2:0]` desde el circuito discreto.
2. Los tres bits son sincronizados con el reloj interno de la FPGA.
3. El nuevo valor se almacena como posición candidata.
4. Se comprueba su estabilidad utilizando `ce_1ms`.
5. Si el valor cambia, se reinicia la comprobación.
6. Si permanece estable durante el tiempo establecido, se actualiza `position`.
7. Se genera un pulso en `position_valid`.

#### Codificación de la posición

Al utilizar un bus de tres bits es posible representar las ocho posiciones del juego.

| `position[2]` | `position[1]` | `position[0]` | Posición |
|:---:|:---:|:---:|---:|
| 0 | 0 | 0 | 0 |
| 0 | 0 | 1 | 1 |
| 0 | 1 | 0 | 2 |
| 0 | 1 | 1 | 3 |
| 1 | 0 | 0 | 4 |
| 1 | 0 | 1 | 5 |
| 1 | 1 | 0 | 6 |
| 1 | 1 | 1 | 7 |

#### Relación con el sistema

La salida `position` representa la posición que será utilizada durante el turno, mientras que `position_valid` informa a la máquina de estados principal que una nueva posición ha sido recibida correctamente.

La máquina de estados utiliza `position_valid` para continuar con el inicio de la ventana de juego.

Este módulo permite que el enlace paralelo con el circuito discreto sea utilizado de forma más confiable, evitando que cambios transitorios o inestables sean interpretados como posiciones válidas.

### 7.6 `mole_request_generator`

El módulo `mole_request_generator` se encarga de generar la señal `solicitud_topo`, utilizada para indicar al subsistema de lógica discreta que debe generar una nueva posición para el siguiente turno del juego.

La máquina de estados principal determina cuándo es necesario solicitar una nueva posición y genera un pulso mediante la señal `start`. A partir de este evento, `mole_request_generator` controla la duración de la señal enviada al circuito externo y administra posibles solicitudes recibidas mientras el módulo todavía se encuentra ocupado.

#### Entradas y salidas

| Señal | Tipo | Descripción |
|---|---|---|
| `clk` | Entrada | Reloj principal del sistema |
| `reset` | Entrada | Reinicio del módulo |
| `ce_1ms` | Entrada | Habilitación utilizada como referencia temporal |
| `start` | Entrada | Orden proveniente del controlador para generar una nueva solicitud |
| `solicitud_topo` | Salida | Señal enviada al subsistema de lógica discreta |
| `busy` | Salida | Indica que actualmente se está generando una solicitud |
| `done` | Salida | Pulso que indica que la solicitud ha finalizado |

#### Funcionamiento

Cuando se recibe un pulso en `start` y el módulo no se encuentra ocupado, la señal `solicitud_topo` se activa. Al mismo tiempo, `busy` pasa a nivel alto para indicar que existe una solicitud en proceso.

La duración de `solicitud_topo` se controla mediante un contador interno que avanza utilizando `ce_1ms`. De esta manera, el tiempo de activación puede definirse directamente en milisegundos.

En la implementación final se configuró:

```text
REQUEST_PULSE_MS = 500 ms
```

Por lo tanto, cada solicitud permanece activa durante aproximadamente 500 ms. Una vez finalizado este intervalo, `solicitud_topo` y `busy` regresan a nivel bajo y se genera un pulso en `done`.

La secuencia de funcionamiento se resume en la siguiente tabla:

| Condición | `solicitud_topo` | `busy` | `done` | Acción |
|---|:---:|:---:|:---:|---|
| Estado inicial | 0 | 0 | 0 | El módulo espera una solicitud |
| `start = 1` | 1 | 1 | 0 | Inicia una nueva solicitud |
| Durante el intervalo configurado | 1 | 1 | 0 | La solicitud permanece activa |
| Final del intervalo | 0 | 0 | 1 | Finaliza la solicitud |
| Después de finalizar | 0 | 0 | 0 | El módulo vuelve a estar disponible |

#### Manejo de solicitudes pendientes

El módulo también contempla la posibilidad de recibir una nueva orden mientras una solicitud anterior todavía se encuentra activa.

Si `start` se activa mientras `busy = 1`, la nueva petición se almacena internamente como una solicitud pendiente. Esto permite evitar que una orden proveniente de la máquina de estados se pierda por encontrarse el generador ocupado.

Al finalizar la solicitud actual, el módulo procesa posteriormente la solicitud almacenada. Entre ambas solicitudes se mantiene un intervalo en nivel bajo, permitiendo que el circuito discreto pueda distinguir el final de una solicitud y el comienzo de la siguiente.

Este comportamiento mejora la confiabilidad de la comunicación entre la FPGA y el subsistema discreto, especialmente cuando las órdenes se producen con poca separación temporal.

#### Relación con el sistema

`mole_request_generator` sirve como interfaz entre la máquina de estados principal y el circuito de lógica discreta.

La máquina de estados determina **cuándo** debe solicitarse una nueva posición, mientras que este módulo determina **cómo y durante cuánto tiempo** debe mantenerse activa la señal física `solicitud_topo`.

La secuencia general es:

1. La máquina de estados genera `start`.
2. `mole_request_generator` activa `solicitud_topo`.
3. El circuito discreto recibe la solicitud.
4. El circuito discreto genera una nueva posición.
5. Al finalizar el tiempo configurado, el generador desactiva `solicitud_topo`.
6. `done` indica que el proceso de solicitud terminó.

Esta separación permite mantener independiente la lógica de control del juego de la temporización necesaria para comunicarse con el circuito externo.

### 7.7 `game_hit_evaluator`

## Entradas

| Señal | Tipo | Descripción |
|---|---|---|
| `turn_active` | `logic` | Bandera que indica si el sistema debe evaluar entradas en ese momento (turno de juego en curso). |
| `active_position` | `logic [2:0]` | Índice binario (0–7) que indica cuál de los 8 topos está activo actualmente. |
| `buttons_pulse` | `logic [7:0]` | Vector de 8 bits donde cada bit representa el pulso de un botón físico; se espera que solo un bit esté en 1 cuando el jugador presiona. |

## Salidas

| Señal | Tipo | Descripción |
|---|---|---|
| `active_mole_onehot` | `logic [7:0]` | Representación one-hot de `active_position`; tiene un único bit en 1 correspondiente a la posición del topo activo. |
| `any_press` | `logic` | Se activa (`1`) cuando al menos un bit de `buttons_pulse` está en 1, es decir, hubo alguna pulsación. |
| `hit_pulse` | `logic` | Se activa cuando el botón presionado coincide exactamente con la posición del topo activo. |
| `miss_pulse` | `logic` | Se activa cuando hubo una pulsación pero no coincide con la posición del topo activo. |

## Funcionamiento 

La señal `active_position` llega como un número binario de 3 bits (0 a 7), pero para compararla directamente contra `buttons_pulse` (que es un vector de 8 bits, uno por botón), se necesita convertirla a formato **one-hot**. Esto se logra con: `active_mole_onehot = 8'b0000_0001 << active_position`
Esta operación desplaza un único bit en 1 hacia la izquierda tantas posiciones como indique `active_position`. Por ejemplo, si `active_position = 3`, el resultado es `8'b0000_1000`, es decir, el bit correspondiente al topo #3 queda en 1 y todos los demás en 0.

Una vez obtenida esta representación, el módulo evalúa el resultado de la jugada solo si `turn_active` está activo y `any_press` detectó una pulsación:

- **Acierto (`hit_pulse`)**: ocurre cuando `buttons_pulse` es **exactamente igual** a `active_mole_onehot`, es decir, el jugador presionó el único botón correspondiente a la posición del topo activo.
- **Fallo (`miss_pulse`)**: ocurre cuando hubo pulsación (`any_press = 1`) pero `buttons_pulse` **no coincide** con `active_mole_onehot`, ya sea porque se presionó un botón incorrecto o porque se presionó más de un botón simultáneamente.

Esta comparación exacta (`==`) es lo que garantiza que solo se considere acierto cuando el botón presionado corresponde precisamente a la posición activa, descartando cualquier otra combinación como fallo.

## Relación con el sistema

Este módulo actúa como el **evaluador de jugadas** dentro del sistema "Whack-a-mole": recibe la posición del topo activo (generada por la lógica de control/secuenciador del juego) y las pulsaciones físicas de los botones (ya sincronizadas/depuradas como pulsos), y produce las señales `hit_pulse` / `miss_pulse` que la lógica de control superior (contador de puntaje, máquina de estados del juego, temporizador de ronda) utiliza para actualizar el marcador, avanzar de ronda o determinar el fin del juego. Al ser puramente combinacional (`always_comb`), no introduce retardo de reloj adicional: su salida depende únicamente del estado actual de sus entradas en cada ciclo.

### 7.8 `turn_window_timer`

## Entradas

| Señal | Tipo | Descripción |
|---|---|---|
| `clk` | `logic` | Señal de reloj del sistema; el bloque secuencial se actualiza en cada flanco de subida. |
| `reset` | `logic` | Reset síncrono; al activarse, limpia el contador y desactiva la ventana de turno. |
| `ce_1ms` | `logic` | Pulso habilitador que ocurre cada 1 ms; actúa como base de tiempo para incrementar el contador. |
| `start` | `logic` | Señal que inicia una nueva ventana de turno, reiniciando el contador y activando `active`. |
| `cancel` | `logic` | Señal que cancela la ventana activa antes de que expire (ej. cuando el jugador ya acertó). |
| `duration_ms` | `logic [10:0]` | Duración total de la ventana de turno, expresada en milisegundos. |

## Salidas

| Señal | Tipo | Descripción |
|---|---|---|
| `active` | `logic` | Indica si la ventana de turno está actualmente en curso (contando tiempo). |
| `timeout_pulse` | `logic` | Pulso de un solo ciclo de reloj que se activa cuando el tiempo de la ventana se agota sin cancelación. |

## Funcionamiento (Conteo de ventana de tiempo y prioridad de cancelación)

El módulo implementa un temporizador descendente basado en un contador ascendente interno (`elapsed_ms`) que se compara contra `duration_ms`. La base de tiempo la da `ce_1ms`, un pulso externo de 1 ms, de modo que `elapsed_ms` solo avanza un conteo por cada milisegundo real transcurrido, y no en cada flanco de `clk`.

La lógica evalúa las condiciones en el siguiente orden de prioridad:

1. **`reset`**: limpia todo el estado (mayor prioridad, síncrono).
2. **`cancel`**: cierra la ventana (`active = 0`) y reinicia el contador **sin** generar `timeout_pulse`. Esto evita que, si el jugador ya golpeó el topo correcto (evento externo que dispara `cancel`), el temporizador genere un timeout tardío e inválido.
3. **`start`**: reinicia el contador y activa la ventana, dando inicio a una nueva medición.
4. **Conteo normal** (`active && ce_1ms`): en cada pulso de 1 ms, se compara `elapsed_ms` contra `duration_ms - 1`. Se usa `duration_ms - 1` porque el conteo empieza en 0, así que al llegar a `duration_ms - 1` ya transcurrieron `duration_ms` milisegundos completos. También se contempla el caso borde `duration_ms <= 1`, generando el timeout inmediatamente en el primer pulso para evitar desbordes o comparaciones inválidas.
   - Si se cumple la condición de expiración: se reinicia el contador, se desactiva `active` y se emite `timeout_pulse` por un ciclo.
   - Si no, simplemente se incrementa `elapsed_ms`.

## Relación con el sistema

Este módulo funciona como el **reloj de la ventana de reacción** dentro del sistema "Whack-a-mole": mide cuánto tiempo tiene el jugador para golpear el topo activo antes de que se considere un turno perdido. La señal `start` normalmente la genera la máquina de estados principal al activar un nuevo topo; `cancel` se dispara desde la lógica de evaluación de aciertos (`game_hit_evaluator`) cuando ocurre un `hit_pulse`, evitando un timeout espurio tras un golpe exitoso. La salida `timeout_pulse` alimenta a la máquina de estados de control para registrar el fallo por tiempo agotado y avanzar a la siguiente ronda, mientras que `active` puede usarse para habilitar otras señales (como indicadores visuales) mientras el turno está en curso.

### 7.9 `difficulty_controller`

## Entradas

| Señal | Tipo | Descripción |
|---|---|---|
| `clk` | `logic` | Señal de reloj del sistema; la duración se actualiza en cada flanco de subida. |
| `reset` | `logic` | Reset síncrono; al activarse, restaura `duration_ms` a `INITIAL_MS` (1500 ms). |
| `hit_pulse` | `logic` | Pulso de acierto; cada vez que se activa, reduce la duración de la ventana en `STEP_MS`. |
| `miss_pulse` | `logic` | Pulso de fallo; al activarse, la duración actual se mantiene sin cambios. |

### Parámetros

| Parámetro | Valor por defecto | Descripción |
|---|---|---|
| `INITIAL_MS` | 1500 ms | Duración de la ventana antes de cualquier acierto. |
| `MINIMUM_MS` | 500 ms | Duración mínima a la que puede llegar la ventana (piso de dificultad). |
| `STEP_MS` | 100 ms | Cantidad en que se reduce la duración por cada acierto acumulado. |

## Salidas

| Señal | Tipo | Descripción |
|---|---|---|
| `duration_ms` | `logic [10:0]` | Duración vigente de la ventana de reacción, en milisegundos; se recalcula con cada acierto y se conserva en cada fallo. |

## Funcionamiento (Escalado de dificultad por aciertos)

El módulo ajusta la dificultad del juego reduciendo progresivamente `duration_ms` (la duración de la ventana de reacción) a medida que el jugador acumula aciertos, según la siguiente relación:

| Aciertos que reducen | Duración |
|---|---|
| 0 | 1500 ms |
| 1 | 1400 ms |
| 2 | 1300 ms |
| 3 | 1200 ms |
| 4 | 1100 ms |
| 5 | 1000 ms |
| 6 | 900 ms |
| 7 | 800 ms |
| 8 | 700 ms |
| 9 | 600 ms |
| 10 o más | 500 ms |

Cada vez que ocurre `hit_pulse`, la duración se reduce en `STEP_MS` (100 ms), siempre que quede por encima de `MINIMUM_MS + STEP_MS`; en caso contrario, se satura directamente en `MINIMUM_MS` (500 ms) para evitar que el resultado de la resta sea menor al piso definido. Esto reproduce exactamente la tabla: después de 10 aciertos consecutivos, la duración llega a su valor mínimo de 500 ms y ya no sigue bajando.

Cuando ocurre `miss_pulse`, la duración **no cambia** — el comentario del código lo indica explícitamente ("la dificultad alcanzada se conserva después de un fallo"), es decir, un fallo no facilita el juego ni retrocede la dificultad ya ganada; solo los aciertos la modifican.

## Relación con el sistema

Este módulo es el **controlador de dificultad adaptativa** del sistema "Whack-a-mole": recibe directamente `hit_pulse` y `miss_pulse` desde `game_hit_evaluator`, y su salida `duration_ms` alimenta a `turn_window_timer` como el parámetro `duration_ms` de cada nueva ventana de turno (vía la señal `start`). De esta forma, cada vez que el jugador acierta, el siguiente topo tendrá una ventana de tiempo más corta, incrementando la dificultad del juego de forma dinámica y acumulativa, mientras que los fallos no alteran el nivel de dificultad ya alcanzado.

### 7.10 `score_counters`

## Entradas

| Señal | Tipo | Descripción |
|---|---|---|
| `clk` | `logic` | Señal de reloj del sistema; los contadores se actualizan en cada flanco de subida. |
| `reset` | `logic` | Reset síncrono; al activarse, ambos contadores (`hits` y `misses`) vuelven a 0. |
| `hit_pulse` | `logic` | Pulso de acierto; cada vez que se activa, incrementa el contador `hits` en 1. |
| `miss_pulse` | `logic` | Pulso de fallo; cada vez que se activa, incrementa el contador `misses` en 1. |

### Parámetros

| Parámetro | Valor por defecto | Descripción |
|---|---|---|
| `MAX_SCORE` | 99 | Valor máximo que puede alcanzar cada contador antes de dejar de incrementarse. |

## Salidas

| Señal | Tipo | Descripción |
|---|---|---|
| `hits` | `logic [6:0]` | Cantidad acumulada de aciertos del jugador durante la partida. |
| `misses` | `logic [6:0]` | Cantidad acumulada de fallos del jugador durante la partida. |

## Funcionamiento (Conteo saturado de aciertos y fallos)

El módulo mantiene dos contadores independientes de 7 bits (`hits` y `misses`), cada uno incrementándose de forma exclusiva según el pulso correspondiente. Ambos contadores pueden incrementarse en el mismo ciclo si, por alguna razón, llegaran a activarse `hit_pulse` y `miss_pulse` simultáneamente, ya que las dos condiciones se evalúan de forma independiente (no son `else if`).

Cada incremento está protegido por una **condición de saturación**: `hits` solo aumenta si `hits < MAX_SCORE`, y `misses` solo aumenta si `misses < MAX_SCORE`. Esto evita el desbordamiento (overflow) del contador de 7 bits una vez alcanzado el valor máximo definido (99 por defecto), dejando el contador fijo en ese tope en lugar de reiniciarse a 0.

## Relación con el sistema

Este módulo actúa como el **marcador de la partida** dentro del sistema "Whack-a-mole": recibe las mismas señales `hit_pulse` y `miss_pulse` generadas por `game_hit_evaluator` (las mismas que también alimentan a `difficulty_controller`), y lleva el conteo total de aciertos y fallos a lo largo del juego. Sus salidas `hits` y `misses` normalmente se envían a un módulo de visualización (display de 7 segmentos, LEDs, etc.) para mostrarle al jugador su desempeño, y también pueden usarse por la lógica de control superior para determinar condiciones de fin de partida (por ejemplo, un número máximo de rondas o de fallos permitidos).

### 7.11 `consecutive_misses`
 
Lleva la cuenta de los fallos consecutivos del jugador, a diferencia del contador de fallos acumulados (8.10), que nunca se reinicia durante la partida. Un acierto (`hit_pulse`) tiene prioridad y reinicia el contador `miss_count` a cero; un fallo (`miss_pulse`) lo incrementa mientras no haya alcanzado 3. El módulo entrega dos salidas distintas: `three_misses`, una señal de nivel combinacional que permanece en alto mientras el contador esté en 3, y `third_miss_pulse`, un pulso registrado de un solo ciclo generado exactamente en el instante en que se completa el tercer fallo. Esta separación es necesaria porque `game_controller_fsm` (8.13) requiere un evento de un ciclo para disparar la transición hacia el estado de game over, evitando ambigüedades que produciría una señal de nivel.
 
| Señal | Dirección | Descripción |
|---|---|---|
| `clk`, `reset` | Entrada | Reloj y reinicio síncrono. |
| `hit_pulse` | Entrada | Pulso de acierto; reinicia el contador. |
| `miss_pulse` | Entrada | Pulso de fallo; incrementa el contador. |
| `miss_count[1:0]` | Salida | Valor actual del contador (0–3). |
| `three_misses` | Salida | Nivel alto mientras el contador esté en 3. |
| `third_miss_pulse` | Salida | Pulso de un ciclo al completarse el tercer fallo. |

---
 
### 7.12 `game_over_timer`
 
Mide el intervalo de 2000 ms (parámetro `GAME_OVER_MS`) durante el cual el sistema permanece en la pantalla de fin de partida antes de reiniciarse automáticamente. Su estructura reutiliza el mismo principio que `turn_window_timer` (8.8): un contador impulsado por la habilitación temporal `ce_1ms` en lugar de un reloj independiente, con ancho dimensionado automáticamente mediante `$clog2(GAME_OVER_MS)` para que el módulo sea reutilizable ante otros valores del parámetro. Al recibir `start` (proveniente de `game_over_start` en la FSM), el contador arranca y `active` se activa; al cumplirse el tiempo configurado, se genera `done_pulse` durante un ciclo, que la FSM utiliza como `game_over_done` para avanzar hacia el reinicio automático.
 
| Señal | Dirección | Descripción |
|---|---|---|
| `GAME_OVER_MS` | Parámetro | Duración en milisegundos (2000 por defecto). |
| `clk`, `reset` | Entrada | Reloj y reinicio síncrono. |
| `ce_1ms` | Entrada | Habilitación temporal de 1 ms. |
| `start` | Entrada | Arranca el temporizador. |
| `active` | Salida | Indica que el temporizador está en curso. |
| `done_pulse` | Salida | Pulso de un ciclo al cumplirse el tiempo. |

---

### 7.13 `game_controller_fsm`
 
Es el controlador central del juego: coordina la secuencia de un turno completo (solicitud de posición, espera de posición válida, inicio del turno, resolución de acierto o fallo) y gestiona la transición hacia la secuencia de fin de partida y el reinicio automático. Se implementa como una FSM de Moore de 9 estados, con un registro de estado y dos bloques combinacionales (siguiente estado y salidas):

| Estado | Función |
|---|---|
| `ST_REQUEST_START` | Inicia solicitud |
| `ST_WAIT_POSITION` | Espera posición válida |
| `ST_START_TURN` | Inicia la ventana |
| `ST_PLAY` | Espera golpe o timeout |
| `ST_RESOLVE_HIT` | Resuelve acierto |
| `ST_RESOLVE_MISS` | Resuelve fallo |
| `ST_GAME_OVER_START` | Inicia game over |
| `ST_GAME_OVER_WAIT` | Espera dos segundos |
| `ST_AUTO_RESET` | Reinicia datos |

Desde `ST_PLAY`, un acierto (`hit_pulse`) lleva a `ST_RESOLVE_HIT`, que siempre regresa a `ST_REQUEST_START`; un fallo o un `timeout_pulse` llevan a `ST_RESOLVE_MISS`. Ahí se evalúa `third_miss_pulse` (proveniente de 8.11): si no se han acumulado tres fallos consecutivos, la partida continúa; si se cumple la condición, la FSM entra en `ST_GAME_OVER_START → ST_GAME_OVER_WAIT`, donde permanece hasta que `game_over_done` (proveniente de 8.12) indique su finalización. `ST_AUTO_RESET` activa `game_data_reset` para limpiar los contadores de la partida antes de reiniciar el ciclo automáticamente, sin intervención del jugador. La salida `state_debug[3:0]` expone el estado actual únicamente con fines de depuración.

---
### 7.14 `seven_segment_controller`
 
Multiplexa en el tiempo los cuatro dígitos que muestran, de forma simultánea a la vista del usuario, los aciertos y los fallos acumulados (dos dígitos decimales cada uno). Un contador de 2 bits (`scan_index`), incrementado a 1 kHz mediante `ce_1ms`, selecciona cíclicamente el dígito activo; según el dígito, se calcula la unidad o decena correspondiente mediante módulo (`%`) y división entera (`/`) por 10 sobre `hits` o `misses`. El resultado se traduce a los patrones de segmentos mediante una tabla de decodificación activa en bajo, propia del hardware de la Nexys 4 (`seg[0]=A` … `seg[6]=G`). La salida `an[7:0]` se dimensionó según el ancho real del bus de ánodos de los ocho dígitos físicos de la tarjeta, aunque solo se controlan activamente los cuatro primeros; el punto decimal (`dp`) permanece apagado de forma permanente.

### 7.15 `status_indicator`

El módulo `status_indicator` controla el LED que informa visualmente el estado general del juego. Durante una partida activa, el LED permanece encendido de manera continua. Cuando ocurre el final de la partida, el LED comienza a parpadear. Si el sistema no está jugando ni se encuentra en estado de `game over`, el LED permanece apagado.

En la implementación física, esta señal se muestra mediante el LED de estado de la FPGA.

#### Interfaz del módulo

| Señal | Dirección | Descripción |
| ----- | :---: | --- |
| `clk` | Entrada | Reloj principal de 100 MHz. |
| `reset` | Entrada | Reinicio síncrono activo en alto. |
| `ce_1ms` | Entrada | Pulso de habilitación generado cada milisegundo. |
| `game_active` | Entrada | Indica que existe una partida activa. |
| `game_over` | Entrada | Indica que la partida ha finalizado. |
| `status_led` | Salida | Señal que controla el LED indicador. |

El módulo incluye el siguiente parámetro:

| Parámetro | Valor predeterminado | Descripción |
| --- | ---: | --- |
| `BLINK_MS` | `250` | Duración, en milisegundos, de cada estado del parpadeo. Corresponde a medio periodo. |

#### Funcionamiento durante la partida

Cuando `game_active` se encuentra activo y `game_over` está desactivado, la salida se mantiene en nivel alto:

```text
game_active = 1
game_over   = 0
status_led  = 1
```

En esta condición, el LED permanece encendido de forma continua para indicar que el juego se encuentra en ejecución.

#### Funcionamiento durante game over

Cuando `game_over` se activa, el módulo utiliza `ce_1ms` para contar intervalos de tiempo. El registro `blink_counter` se incrementa una vez por milisegundo hasta alcanzar:

```text
BLINK_MS - 1
```

Con el valor predeterminado:

```text
BLINK_MS - 1 = 249
```

Al completar 250 pulsos de `ce_1ms`, el contador vuelve a cero y `blink_state` cambia de estado:

```systemverilog
blink_state <= ~blink_state;
```

Por lo tanto, el LED permanece 250 ms apagado y 250 ms encendido. El periodo completo del parpadeo es:

```text
Tparpadeo = 2 × BLINK_MS
           = 2 × 250 ms
           = 500 ms
```

La frecuencia resultante es:

```text
fparpadeo = 1 / 0.5 s
           = 2 Hz
```

El comportamiento aproximado es:

```text
Tiempo:       0–249 ms   250–499 ms   500–749 ms   750–999 ms
status_led:      0            1            0             1
```

El parpadeo comienza con el LED apagado porque `blink_state` se inicializa en cero.

#### Prioridad de las señales

La lógica de salida asigna prioridad a `game_over` sobre `game_active`:

```systemverilog
if (game_over)
    status_led = blink_state;
else if (game_active)
    status_led = 1'b1;
else
    status_led = 1'b0;
```

Esto significa que, si ambas señales se activaran simultáneamente, el LED mostraría el patrón parpadeante correspondiente al final de la partida.

La tabla de comportamiento es la siguiente:

| `game_over` | `game_active` | `status_led` | Indicación |
| :---: | :---: | :---: | --- |
| 0 | 0 | 0 | Sistema inactivo |
| 0 | 1 | 1 | Partida activa |
| 1 | 0 | `blink_state` | Fin de partida |
| 1 | 1 | `blink_state` | Fin de partida con prioridad |

#### Reinicio del parpadeo

Cuando se activa `reset`, tanto el contador como el estado de parpadeo regresan a cero:

```systemverilog
blink_counter <= '0;
blink_state   <= 1'b0;
```

El contador también se limpia cuando `game_over` está desactivado. Esta decisión garantiza que cada vez que se ingrese al estado de final de partida, el patrón de parpadeo comience desde una condición conocida.

```text
game_over = 0
      |
      v
blink_counter = 0
blink_state   = 0
```

De esta forma, un parpadeo anterior no afecta el inicio del siguiente.

#### Decisiones de diseño

Se utilizó `ce_1ms` como habilitación temporal en lugar de generar un reloj independiente para el LED. Esto mantiene el módulo dentro del mismo dominio de reloj que el resto del sistema.

Las principales decisiones fueron:

- Mantener el LED fijo durante una partida activa.
- Utilizar un patrón parpadeante para diferenciar claramente el final del juego.
- Dar prioridad visual a `game_over`.
- Reiniciar la fase de parpadeo al abandonar el estado de finalización.
- Parametrizar el tiempo mediante `BLINK_MS`.
- Utilizar asignaciones no bloqueantes en la lógica secuencial.
- Separar el contador secuencial de la lógica combinacional de salida.

#### Resumen de operación

```text
Sistema inactivo  -> LED apagado
Partida activa    -> LED encendido fijo
Game over         -> LED parpadeante a 2 Hz
Reset             -> LED y contador reiniciados
```

En consecuencia, `status_indicator` permite conocer rápidamente el estado general del juego sin utilizar los displays de puntuación ni observar señales internas de depuración.

### 7.16 `whack_a_mole_top`

El módulo `whack_a_mole_top` corresponde al nivel superior del subsistema implementado en la FPGA. Su función principal es integrar los diferentes módulos desarrollados y establecer las conexiones necesarias para ejecutar la lógica completa del juego.

En este módulo se reciben las señales provenientes del circuito discreto y de los pulsadores externos, mientras que internamente se coordinan la recepción de la posición, la evaluación de la jugada, la temporización, los contadores, la dificultad, el control de Game Over y la visualización de resultados.

#### Parámetros principales

| Parámetro | Valor utilizado | Descripción |
|---|---:|---|
| `CLK_FREQ_HZ` | 100 MHz | Frecuencia del reloj principal de la FPGA |
| `BUTTON_DEBOUNCE_MS` | 10 ms | Tiempo de antirrebote de los pulsadores |
| `POSITION_STABLE_MS` | 2 ms | Tiempo requerido para validar una posición |
| `REQUEST_PULSE_MS` | 500 ms | Duración de la señal `solicitud_topo` |
| `INITIAL_MS` | 1500 ms | Duración inicial de la ventana de juego |
| `MINIMUM_MS` | 500 ms | Duración mínima de la ventana |
| `STEP_MS` | 100 ms | Reducción de tiempo producida por cada acierto |
| `GAME_OVER_MS` | 2000 ms | Duración del estado de fin de juego |
| `STATUS_BLINK_MS` | 250 ms | Periodo utilizado para el parpadeo del LED de estado |

#### Entradas y salidas

| Señal | Tipo | Descripción |
|---|---|---|
| `clk` | Entrada | Reloj principal de 100 MHz |
| `reset_button` | Entrada | Pulsador utilizado para reiniciar el sistema |
| `position_async[2:0]` | Entrada | Posición generada por el circuito discreto |
| `buttons_async[7:0]` | Entrada | Ocho pulsadores externos del jugador |
| `solicitud_topo` | Salida | Solicitud enviada al circuito discreto para generar una nueva posición |
| `mole_leds[7:0]` | Salida | Representación one-hot de la posición activa |
| `status_led` | Salida | Indicador del estado general del juego |
| `seg[6:0]` | Salida | Control de los segmentos del display |
| `dp` | Salida | Control del punto decimal |
| `an[7:0]` | Salida | Selección de los dígitos del display |

#### Funcionamiento

El módulo principal coordina el funcionamiento de los diferentes bloques del sistema. Todos los módulos trabajan utilizando el mismo reloj principal de 100 MHz, mientras que `ce_1ms_generator` produce una habilitación periódica utilizada por los bloques que requieren medición de tiempo en milisegundos.

El pulsador de reset es una señal externa y se sincroniza antes de utilizarse dentro del sistema. Posteriormente, las señales externas correspondientes a los botones y a la posición del topo son procesadas por `button_bank` y `parallel_position_receiver`, respectivamente.

La posición recibida es validada antes de iniciar un nuevo turno. Al mismo tiempo, `mole_request_generator` se encarga de generar la señal `solicitud_topo` cuando la máquina de estados solicita una nueva posición.

Durante un turno, `game_hit_evaluator` compara la posición activa con los pulsos producidos por los botones. De esta comparación se determina si el jugador realizó un acierto o un fallo.

El módulo `turn_window_timer` controla el tiempo disponible para realizar cada golpe. Si el jugador no presiona un botón antes de terminar la ventana, se genera un evento de timeout.

Los resultados de cada turno son utilizados por los módulos encargados de la dificultad, los puntajes y los fallos consecutivos. Cuando se producen tres fallos consecutivos, la máquina de estados inicia el proceso de Game Over.

Finalmente, `seven_segment_controller` muestra los aciertos y fallos acumulados en los displays, mientras que `status_indicator` controla el LED utilizado para indicar el estado del juego.

#### Módulos integrados

El módulo `whack_a_mole_top` instancia los siguientes bloques:

| Módulo | Función |
|---|---|
| `ce_1ms_generator` | Genera la habilitación temporal de 1 ms |
| `button_bank` | Sincroniza y filtra los ocho pulsadores |
| `parallel_position_receiver` | Sincroniza y valida la posición recibida |
| `mole_request_generator` | Genera la solicitud de una nueva posición |
| `game_hit_evaluator` | Determina si una pulsación corresponde a acierto o fallo |
| `turn_window_timer` | Controla la duración de cada turno |
| `difficulty_controller` | Reduce progresivamente la duración de la ventana |
| `score_counters` | Almacena los aciertos y fallos acumulados |
| `consecutive_misses` | Detecta tres fallos consecutivos |
| `game_over_timer` | Controla la duración del estado Game Over |
| `game_controller_fsm` | Coordina la secuencia principal del juego |
| `seven_segment_controller` | Controla los displays de siete segmentos |
| `status_indicator` | Controla el LED indicador del estado |

#### Señal `data_reset`

El sistema puede reiniciarse de dos formas diferentes. La primera corresponde al reset manual generado mediante `reset_button`, mientras que la segunda corresponde al reinicio automático generado por la máquina de estados después de finalizar una partida.

Para combinar ambos eventos se utiliza:

```systemverilog
assign data_reset = reset | game_data_reset;
```

La señal `data_reset` es utilizada por los módulos que almacenan información propia de una partida, como el temporizador del turno, el controlador de dificultad, los contadores de puntaje y el contador de fallos consecutivos.

De esta manera, cuando se produce un Game Over y finaliza el tiempo correspondiente, la máquina de estados puede reiniciar los datos del juego sin necesidad de que el jugador presione nuevamente el botón de reset.

#### Señal `effective_miss_pulse`

Dentro del juego un fallo puede producirse de dos maneras diferentes:

- El jugador presiona un botón que no corresponde con la posición activa.
- Se agota el tiempo disponible sin que se produzca un acierto.

El primer caso produce `button_miss_pulse`, mientras que el segundo genera `timeout_pulse`.

Para que los módulos encargados de puntajes, dificultad y fallos consecutivos no tengan que manejar ambos eventos de forma independiente, se genera:

```systemverilog
assign effective_miss_pulse = button_miss_pulse | timeout_pulse;
```

Por lo tanto, `effective_miss_pulse` representa cualquier evento que deba ser considerado como un fallo dentro del juego.

Esta señal es utilizada por `difficulty_controller`, `score_counters` y `consecutive_misses`, permitiendo que un fallo por botón incorrecto y un fallo por tiempo agotado produzcan el mismo efecto sobre los datos de la partida.

#### Flujo general de una jugada

El funcionamiento integrado del módulo principal puede resumirse en los siguientes pasos:

1. La máquina de estados solicita una nueva posición.
2. `mole_request_generator` activa `solicitud_topo`.
3. El circuito discreto genera una nueva posición.
4. `parallel_position_receiver` sincroniza y valida la posición recibida.
5. La máquina de estados inicia un nuevo turno.
6. `turn_window_timer` abre la ventana temporal correspondiente.
7. `button_bank` detecta las pulsaciones válidas realizadas por el jugador.
8. `game_hit_evaluator` determina si la pulsación corresponde a un acierto o a un fallo.
9. Si se agota el tiempo, el evento también es considerado como un fallo.
10. Los contadores y el controlador de dificultad se actualizan según el resultado.
11. `consecutive_misses` determina si se alcanzaron tres fallos consecutivos.
12. Si la partida puede continuar, se solicita una nueva posición.
13. Si se alcanzan tres fallos consecutivos, se inicia el estado de Game Over.
14. Al finalizar Game Over, se genera `game_data_reset` y comienza automáticamente una nueva partida.

La integración de estas funciones dentro de `whack_a_mole_top` permite mantener una estructura modular, donde cada bloque realiza una tarea específica y el módulo principal se encarga de establecer las conexiones entre todos ellos.

---

## 8. Asignación de pines

La asignación de pines se definió en el archivo de restricciones `whack_a_mole_top.xdc`. Todas las señales digitales externas utilizan el estándar eléctrico `LVCMOS33`, correspondiente a niveles lógicos de 3.3 V.

### 8.1 Reloj y reset

| Señal | Elemento de la Nexys 4 | Pin FPGA | Descripción |
| ----- | --- | --- | --- |
| `clk` | Oscilador principal | E3 | Reloj de 100 MHz |
| `reset_button` | BTNC | E16 | Reset general activo en alto |

La restricción temporal del reloj se definió con un periodo de 10 ns:

```tcl
create_clock -add -name sys_clk_pin -period 10.000 \
    -waveform {0 5} [get_ports clk]
```

### 8.2 Posición y solicitud

| Señal | Puerto del módulo superior | Conector | Pin FPGA | Dirección |
| ----- | --- | --- | --- | :---: |
| Q0 | `position_async[0]` | JA1 | B13 | Entrada |
| Q1 | `position_async[1]` | JA2 | F14 | Entrada |
| Q2 | `position_async[2]` | JA3 | D17 | Entrada |
| `SOLICITUD_TOPO` | `solicitud_topo` | JA4 | E17 | Salida |

Las señales `Q0`, `Q1` y `Q2` provienen del LFSR implementado en la sección discreta. Debido a que esta sección funciona con niveles cercanos a 5 V, cada línea debe ingresar a la FPGA mediante un circuito de adaptación de nivel. No se deben aplicar directamente 5 V a los pines Pmod.

La salida `solicitud_topo` trabaja a 3.3 V y controla un transistor 2N2222, utilizado para aislar e invertir la señal antes de introducirla al circuito discreto de 5 V.

### 8.3 Botones externos

| Botón | Puerto del módulo superior | Conector | Pin FPGA |
| ----: | --- | --- | --- |
| 0 | `buttons_async[0]` | JB1 | G14 |
| 1 | `buttons_async[1]` | JB2 | P15 |
| 2 | `buttons_async[2]` | JB3 | V11 |
| 3 | `buttons_async[3]` | JB4 | V15 |
| 4 | `buttons_async[4]` | JB7 | K16 |
| 5 | `buttons_async[5]` | JB8 | R16 |
| 6 | `buttons_async[6]` | JB9 | T9 |
| 7 | `buttons_async[7]` | JB10 | U11 |

Los ocho pulsadores se conectaron a entradas Pmod de la FPGA. Cada botón representa una de las ocho posiciones posibles del topo. Las señales ingresan inicialmente como `buttons_async[7:0]` y posteriormente son sincronizadas y filtradas por el banco de botones.

Los botones externos y la FPGA deben compartir una referencia de tierra común. En la conexión utilizada, cada pulsador genera un nivel alto al presionarse y un nivel bajo al liberarse.

### 8.4 LED de posición

Los LED `LD0` a `LD7` de la Nexys 4 muestran la posición recibida desde el circuito discreto. Solamente debe permanecer encendido el LED correspondiente al valor de `position_async[2:0]`.

| Posición | Señal | LED | Pin FPGA |
| ---: | ----- | --- | --- |
| 0 | `mole_leds[0]` | LD0 | T8 |
| 1 | `mole_leds[1]` | LD1 | V9 |
| 2 | `mole_leds[2]` | LD2 | R8 |
| 3 | `mole_leds[3]` | LD3 | T6 |
| 4 | `mole_leds[4]` | LD4 | T5 |
| 5 | `mole_leds[5]` | LD5 | T4 |
| 6 | `mole_leds[6]` | LD6 | U7 |
| 7 | `mole_leds[7]` | LD7 | U6 |

Estos LED permiten verificar visualmente que la FPGA recibió y decodificó correctamente la posición generada por el LFSR.

### 8.5 LED de diagnóstico

Durante la integración se utilizaron los LED `LD8` a `LD14` para observar señales internas sin necesidad de utilizar instrumentación lógica externa.

| LED | Señal observada | Puerto | Pin FPGA |
| --- | --- | --- | --- |
| LD8 | `solicitud_topo` | `debug_leds[0]` | V4 |
| LD9 | Generador de solicitud ocupado (`busy`) | `debug_leds[1]` | U3 |
| LD10 | Solicitud pendiente | `debug_leds[2]` | V1 |
| LD11 | Bit 0 del estado de la FSM | `debug_leds[3]` | R1 |
| LD12 | Bit 1 del estado de la FSM | `debug_leds[4]` | P5 |
| LD13 | Bit 2 del estado de la FSM | `debug_leds[5]` | U1 |
| LD14 | Bit 3 del estado de la FSM | `debug_leds[6]` | R2 |

La combinación de `LD11` a `LD14` permite identificar el estado interno de la máquina principal durante las pruebas físicas. Esta instrumentación fue especialmente útil para determinar si el sistema esperaba una nueva posición, mantenía un turno activo o había ingresado al estado de finalización.

### 8.6 LED de estado

| Señal | LED | Pin FPGA | Función |
| ----- | --- | --- | --- |
| `status_led` | LD15 | P2 | Indicación general del estado del juego |

El comportamiento de `LD15` es el siguiente:

- Apagado cuando el sistema está inactivo.
- Encendido de forma continua durante una partida activa.
- Parpadeante durante el estado de `game over`.

### 8.7 Segmentos del display

Los segmentos del display de siete segmentos son activos en bajo. Esto significa que un segmento se enciende cuando la FPGA coloca un cero lógico en su salida.

| Segmento | Señal | Pin FPGA |
| :---: | ----- | --- |
| a | `seg[0]` | L3 |
| b | `seg[1]` | N1 |
| c | `seg[2]` | L5 |
| d | `seg[3]` | L4 |
| e | `seg[4]` | K3 |
| f | `seg[5]` | M2 |
| g | `seg[6]` | L6 |
| Punto decimal | `dp` | M4 |

El punto decimal no se utiliza para representar los puntajes, por lo que se mantiene apagado.

### 8.8 Selección de dígitos

Los ánodos del display también son activos en bajo. El controlador habilita un dígito a la vez y realiza un barrido suficientemente rápido para producir la percepción de que los cuatro dígitos están encendidos simultáneamente.

| Dígito | Señal | Pin FPGA | Uso en el proyecto |
| -----: | ----- | --- | --- |
| 0 | `an[0]` | N6 | Unidades de aciertos |
| 1 | `an[1]` | M6 | Decenas de aciertos |
| 2 | `an[2]` | M3 | Unidades de fallos |
| 3 | `an[3]` | N5 | Decenas de fallos |
| 4 | `an[4]` | N2 | Apagado |
| 5 | `an[5]` | N4 | Apagado |
| 6 | `an[6]` | L1 | Apagado |
| 7 | `an[7]` | M1 | Apagado |

Aunque la Nexys 4 dispone de ocho dígitos, el proyecto utiliza solamente cuatro: dos para los aciertos y dos para los fallos acumulados.

### 8.9 Consideraciones eléctricas

Para realizar las conexiones se aplicaron las siguientes precauciones:

- Los pines de entrada y salida de la FPGA operan con lógica de 3.3 V.
- Las salidas de 5 V de los integrados 74LS no se conectaron directamente a la FPGA.
- Las líneas `Q0`, `Q1` y `Q2` se adaptaron a un nivel seguro antes de ingresar por JA1, JA2 y JA3.
- La FPGA y la protoboard utilizan una tierra común.
- La señal `solicitud_topo` se conectó al circuito discreto mediante un transistor 2N2222.
- Los botones externos se conectaron de forma que nunca aplicaran más de 3.3 V a las entradas JB.
- Todas las señales de propósito general se configuraron con el estándar `LVCMOS33`.

La tierra común es necesaria para que ambos subsistemas interpreten los niveles lógicos con respecto a la misma referencia eléctrica.

---

## 9. Verificación por simulación

### 9.1 Evidencias

#### Simulación de `button_bank`

Para verificar el módulo `button_bank` se aplicaron cambios rápidos sobre las entradas de los pulsadores para representar el rebote mecánico, seguidos de pulsaciones que permanecieron estables durante el tiempo requerido por el filtro. También se comprobó el comportamiento ante una pulsación prolongada y ante la activación simultánea de dos botones.

Las principales señales observadas fueron `buttons_async`, `buttons_level`, `buttons_pulse`, `ce_1ms`, `error_count` y `pulse_count`.

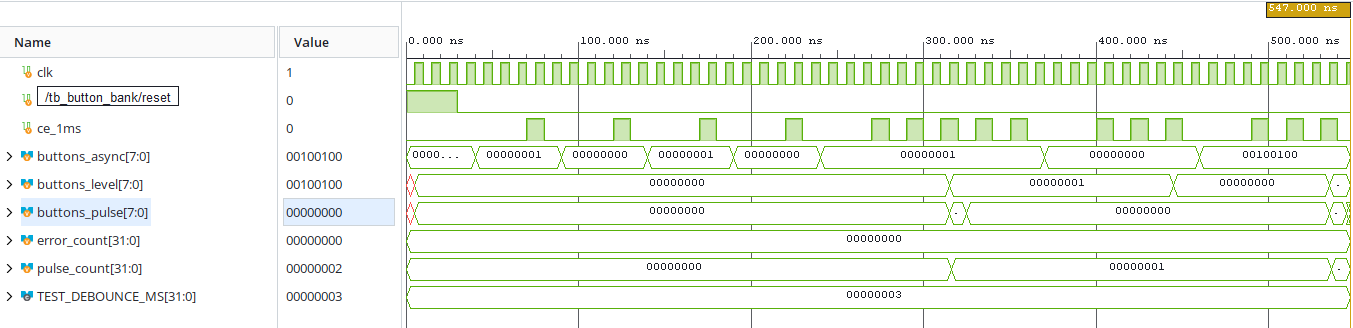
[picture p3: docs/informe/Imagenes/button_bank.png]
Simulación de button_bank


**Simulación del módulo `button_bank`.**

En la simulación se observa que los cambios rápidos presentes en `buttons_async` no modifican inmediatamente `buttons_level`, demostrando el funcionamiento del filtro de antirrebote. Cuando la entrada permanece estable durante el intervalo requerido, `buttons_level` actualiza su valor y `buttons_pulse` genera un único pulso.

Además, mantener un botón presionado no produce pulsos adicionales y la activación simultánea de dos botones se conserva correctamente. El testbench finaliza con `error_count = 0`, por lo que el comportamiento obtenido coincide con el esperado.

---

#### Simulación de `parallel_position_receiver`

Para verificar el módulo `parallel_position_receiver` se aplicaron diferentes valores al bus `position_async[2:0]`. Se incluyeron cambios transitorios de corta duración y posiciones que permanecieron estables durante el intervalo requerido.

Las principales señales observadas fueron `position_async`, `position_sync`, `candidate`, `stable_counter`, `position`, `position_valid`, `error_count` y `valid_count`.

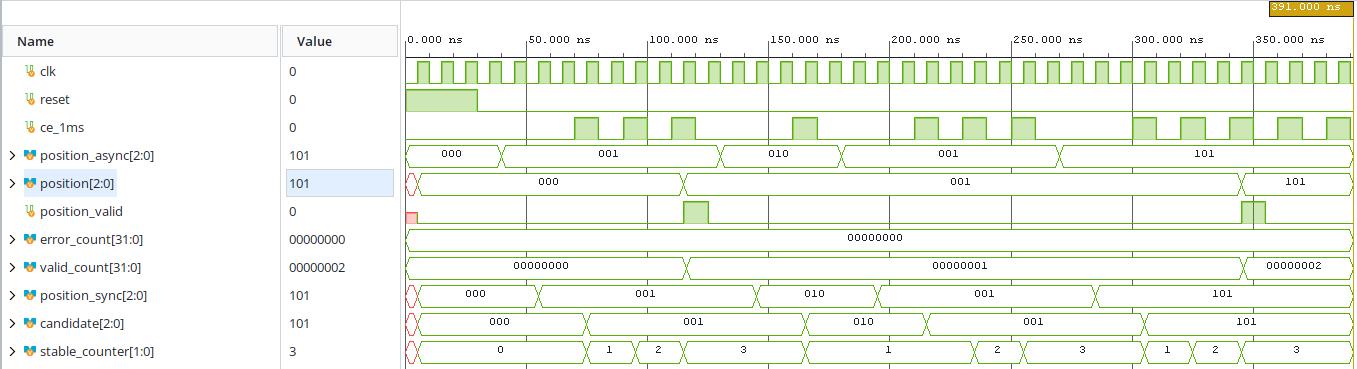
[picture p4: docs/informe/Imagenes/parallel_position_receiver.png]
Simulación de parallel_position_receiver


**Simulación del módulo `parallel_position_receiver`.**

En la simulación se observa que un cambio transitorio en `position_async` es detectado por las etapas internas, pero no se transfiere a la salida `position` al no permanecer estable durante el tiempo requerido.

Cuando una nueva posición permanece estable, el contador completa el intervalo de validación, `position` adopta el nuevo valor y `position_valid` genera un pulso de un ciclo. Durante la prueba se aceptaron correctamente las posiciones estables y se rechazó la transición temporal. El testbench finaliza con `error_count = 0`.

---

#### Simulación de `mole_request_generator`

Para verificar `mole_request_generator` se generaron pulsos en `start` para solicitar nuevas posiciones. Además, se aplicó una segunda solicitud mientras el módulo se encontraba ocupado, con el objetivo de comprobar el almacenamiento y posterior atención de solicitudes pendientes. También se verificó el comportamiento ante una señal de reset durante una solicitud activa.

Las señales principales observadas fueron `start`, `solicitud_topo`, `busy`, `done`, `pending_request`, `pulse_counter`, `ce_1ms` y `error_count`.

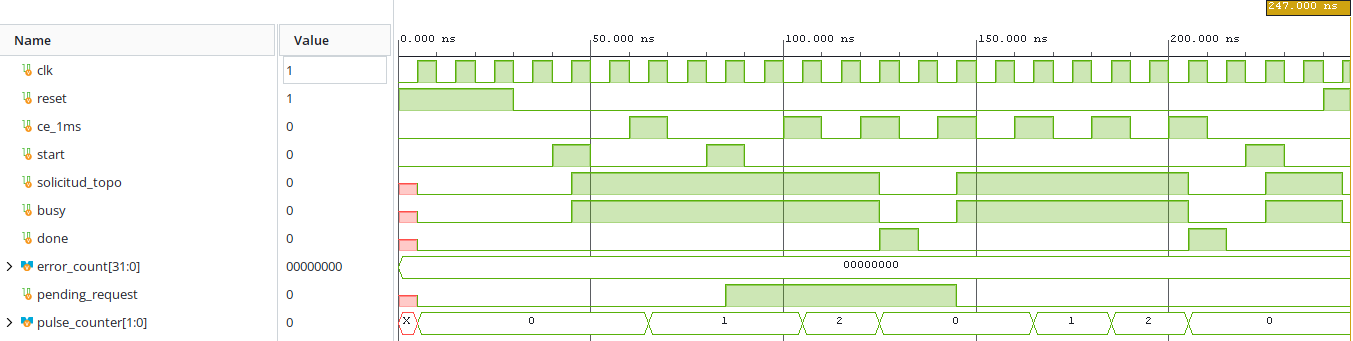
[picture p5: docs/informe/Imagenes/mole_request_generator.png]
Simulación de mole_request_generator


**Simulación del módulo `mole_request_generator`.**

La simulación muestra que un pulso en `start` provoca la activación de `solicitud_topo` y `busy`. El contador interno avanza con las habilitaciones de `ce_1ms` hasta completar la duración configurada, momento en el cual la solicitud termina y se genera un pulso en `done`.

También se observa que, si aparece un nuevo `start` mientras `busy` se encuentra activo, `pending_request` almacena la nueva petición. Al finalizar la primera solicitud, la petición pendiente se procesa posteriormente sin perderse.

Finalmente, el reset aplicado durante una solicitud fuerza `solicitud_topo` y `busy` a su estado inactivo. El testbench concluye con `error_count = 0`, confirmando el funcionamiento esperado.

---

#### Simulación integral de `whack_a_mole_top`

La simulación de `whack_a_mole_top` se utilizó para verificar la interacción entre los principales módulos del sistema. Se simularon solicitudes de nuevas posiciones, respuestas provenientes del circuito discreto y pulsaciones correctas e incorrectas realizadas por el jugador.

Entre las señales observadas se encuentran `solicitud_topo`, `position_async`, `position_valid`, `active_position`, `mole_leds`, `buttons_async`, `buttons_pulse`, `turn_active`, `hit_pulse`, `button_miss_pulse`, `effective_miss_pulse`, `hits`, `misses` y `consecutive_miss_count`.

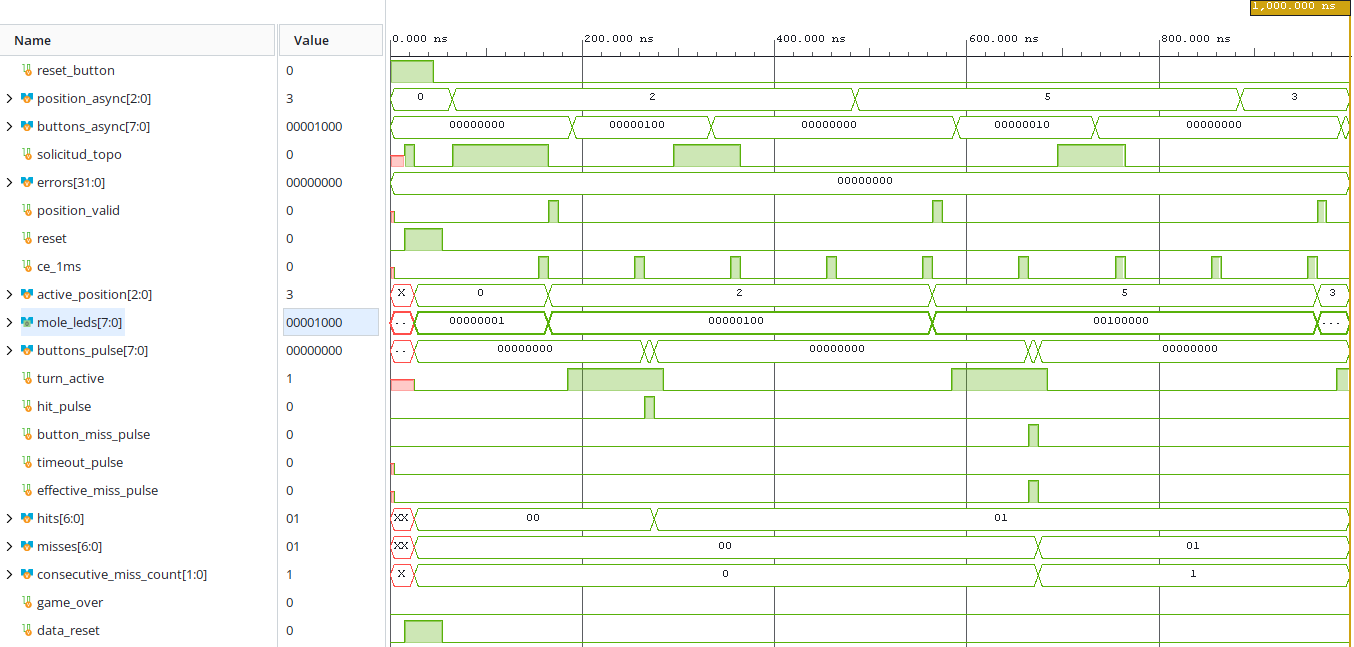
[picture p6: docs/informe/Imagenes/whack_a_mole_top.png]
Simulación integral de whack_a_mole_top


**Simulación integral del módulo `whack_a_mole_top`.**

En el primer turno mostrado se recibe la posición 2, por lo que `active_position` toma este valor y `mole_leds` activa el bit correspondiente. Al presionar el botón asociado a la misma posición se genera `hit_pulse` y el contador `hits` aumenta de 0 a 1.

Posteriormente se recibe la posición 5, pero se activa un botón diferente al correspondiente. Como resultado, se genera `button_miss_pulse` y también `effective_miss_pulse`. Esto provoca que `misses` aumente de 0 a 1 y que `consecutive_miss_count` registre el fallo consecutivo.

La simulación permite comprobar que la solicitud de posición, la recepción del bus paralelo, la evaluación de los botones y la actualización de los contadores funcionan de forma coordinada. El testbench finaliza con `errors = 0`, por lo que la integración evaluada presenta el comportamiento esperado.

#### Simulación de `game_hit_evaluator`

**Consola:** el testbench recorrió las 8 posiciones posibles del topo activo, probando en cada una tanto el caso de acierto (presionar el botón correcto) como el de fallo (presionar uno incorrecto), confirmando que `hit_pulse` y `miss_pulse` se activan correctamente en cada situación. Además se verificaron tres casos borde importantes: que no ocurra nada si no hay pulsación durante el turno, que una pulsación correcta fuera de la ventana de tiempo (`turn_active = 0`) sea ignorada por el módulo, y que presionar dos botones simultáneamente se interprete como fallo (ya que `buttons_pulse` deja de coincidir exactamente con el valor one-hot esperado). Todas las verificaciones dieron **PASS**, cerrando con el mensaje de finalización sin errores.

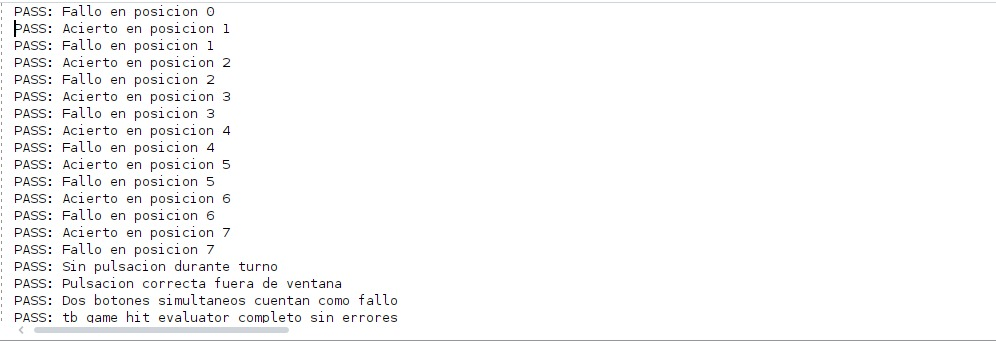
[picture p7: docs/informe/Imagenes/tb_gamehit_1.jpeg]
Simulación game_hit_evaluator 1


**Waveform:** se observa el barrido de `active_position` de 0 a 7, con `active_mole_onehot` reflejando correctamente la conversión one-hot mediante el desplazamiento (`<<`) en cada posición. Por cada valor de posición aparece primero un pulso de `hit_pulse` (cuando `buttons_pulse` coincide exactamente con el one-hot esperado) y luego uno de `miss_pulse` (cuando se prueba un botón distinto), lo que coincide con el patrón visto en la consola. Cerca de los 15 ns se ve un pequeño hueco en la señal `turn_active`, correspondiente al caso de prueba de pulsación correcta fuera de turno: ahí se presiona el botón correcto pero, al estar `turn_active` en 0, ni `hit_pulse` ni `miss_pulse` se activan, demostrando que el módulo respeta la ventana de tiempo. Las señales `position_index`, `expected_mole_onehot` y `wrong_button` son internas del testbench y sirven para generar los estímulos y comparar contra el resultado esperado. `error_count` permanece en 0 durante toda la simulación, confirmando que ninguna comparación falló.

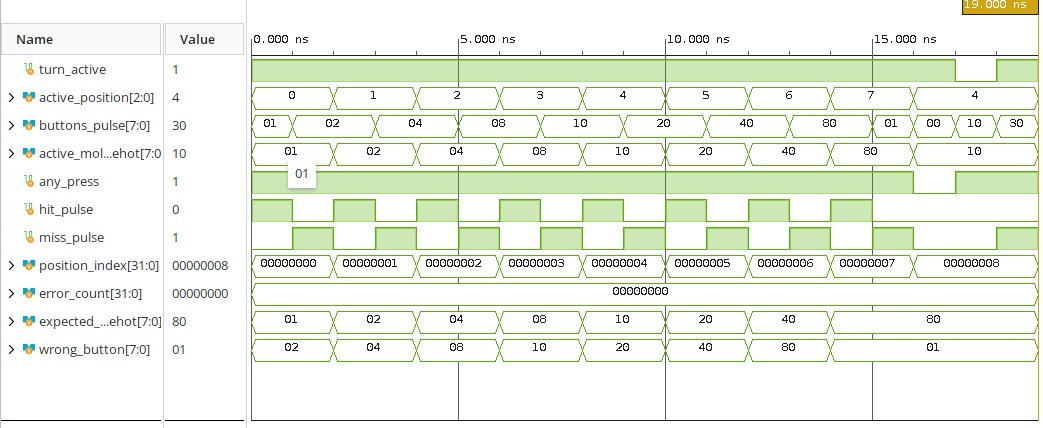
[picture p8: docs/informe/Imagenes/tb_gamehit_2.jpeg]
Simulación game_hit_evaluator 2


#### Simulación de `turn_window_timer`

**Consola:** se validó en primer lugar que `reset` cierra la ventana (`active = 0`) y que `start` la abre correctamente, iniciando el conteo. Se comprobó que `active` se mantiene en alto mientras transcurren los pulsos de `ce_1ms` sin llegar aún a `duration_ms`, y luego que ocurre un timeout exacto al llegar a 5 ms, verificando además que ese `timeout_pulse` dura exactamente un ciclo de reloj y no se queda activado. También se probó que `cancel` cierra la ventana inmediatamente **sin** generar `timeout_pulse`, y que una ventana ya cancelada no produce un timeout tardío aunque sigan llegando pulsos de `ce_1ms`. Por último se verificó que el temporizador puede reiniciarse con una duración distinta (3 ms) generando el timeout en el momento correcto, y el caso borde de duración mínima (1 ms), donde el timeout debe ocurrir en el primer pulso sin esperar un ciclo adicional. Todas las pruebas resultaron en **PASS**, sin errores.

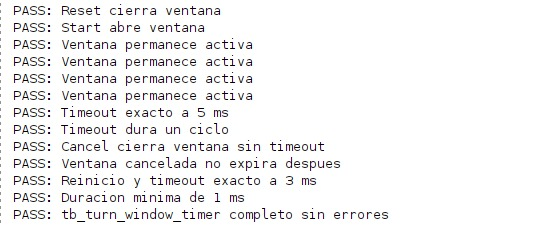
[picture p9: docs/informe/Imagenes/tb_windowtimer_1.jpeg]
Simulación turn_window_timer 1


**Waveform:** la señal `duration_ms` cambia entre tres valores a lo largo de la simulación (`005`, `003` y `001`), cada uno correspondiente a un escenario de prueba distinto. Cada vez que se activa `start`, `active` sube a 1 inmediatamente y permanece así mientras transcurre el conteo, hasta que ocurre el timeout (visible como un pulso corto en `timeout_pulse`, alineado con el momento en que `active` vuelve a 0) o hasta que se activa `cancel`. Se observa con claridad que, alrededor de los 200 ns, al activarse `cancel`, `active` baja a 0 de inmediato sin que aparezca ningún pulso en `timeout_pulse`, confirmando visualmente la prioridad de la cancelación sobre la lógica de expiración normal descrita en el código. La señal `error_count` se mantiene en 0 durante toda la simulación, indicando que ninguna verificación falló.

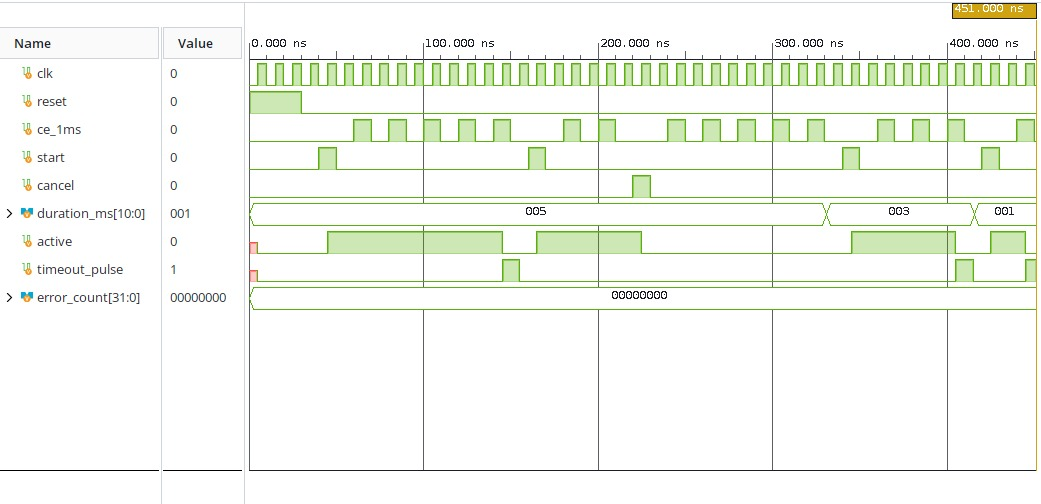
[picture p10: docs/informe/Imagenes/tb_windowtimer_2.jpeg]
Simulación turn_window_timer 2


#### Simulación de `difficulty_controller`

**Consola:** se verificó primero que, tras `reset`, la duración inicial corresponde a 1500 ms. Luego se probó, acierto por acierto, que cada `hit_pulse` reduce `duration_ms` exactamente en 100 ms, siguiendo la tabla completa de diseño (1400, 1300, 1200, 1100, 1000, 900, 800, 700 y 600 ms para los aciertos 1 a 9, y 500 ms en el acierto 10). Se confirmó también que aciertos adicionales más allá del décimo no hacen bajar la duración por debajo del mínimo definido, es decir, que la saturación funciona correctamente. Adicionalmente se comprobó que un `miss_pulse` no modifica la duración actual (conservando la dificultad ya alcanzada), y que un nuevo `reset` restaura la duración a su valor inicial de 1500 ms sin importar cuánto se hubiera reducido previamente. Todas las verificaciones resultaron en **PASS**, replicando exactamente la tabla de diseño proporcionada.

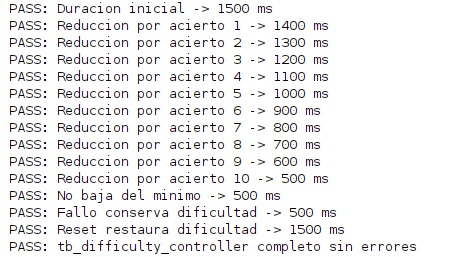
[picture p11: docs/informe/Imagenes/tb_difficutycontroller_1.jpeg]
Simulación difficulty_controller 1


**Waveform:** la señal `duration_ms` desciende en formato hexadecimal siguiendo fielmente la tabla de diseño (`5dc` = 1500 → `578` = 1400 → `514` = 1300 → `4b0` = 1200 → `44c` = 1100 → `3e8` = 1000 → `384` = 900 → `320` = 800 → `2bc` = 700 → `258` = 600 → `1f4` = 500), y cada transición está alineada exactamente con un pulso de `hit_pulse`. Hacia el final de la simulación aparece un pulso de `miss_pulse`, y se observa que `duration_ms` no cambia en absoluto tras ese pulso, quedando fijo en `1f4` (500), lo cual confirma en la forma de onda que los fallos no afectan la dificultad ya ganada. Las señales `hit_index` y `expected_duration` son internas del testbench: llevan el número de acierto que se está probando y el valor de duración esperado para compararlo contra el valor real generado por el módulo. La señal `error_count` permanece en 0 durante toda la simulación, confirmando que ninguna comparación falló.

Simulación difficulty_controller 2

#### Simulación de `score_counters`

**Consola:** se confirmó primero que `reset` limpia ambos contadores (`hits` y `misses`) a 0, y que ambos cuentan de forma completamente independiente entre sí, es decir, que un `hit_pulse` no afecta a `misses` y viceversa. Luego se verificó que ambos contadores saturan correctamente al llegar al valor máximo definido (99), dejando de incrementarse aunque sigan llegando más pulsos del tipo correspondiente, evitando así un desbordamiento del contador de 7 bits. Finalmente se comprobó que, incluso después de que ambos contadores quedaran saturados en 99, un nuevo `reset` los limpia correctamente de vuelta a 0. Todas las pruebas resultaron en **PASS**, cerrando con el mensaje de finalización sin errores, y el resumen de la herramienta de simulación (XSim) confirma que la ejecución corrió sin fallas durante los 1000 ns de tiempo simulado.

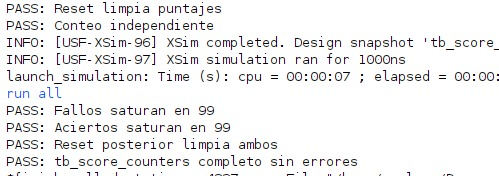
[picture p12: docs/informe/Imagenes/tb_scorecounter_1.jpeg]
Simulación score_counters 1


**Waveform:** al inicio de la simulación se aplica una ráfaga de `miss_pulse` (desde 0 hasta aproximadamente 2 µs), durante la cual `misses` sube progresivamente hasta saturarse en `63` (equivalente a 99 en decimal), mientras que `hits` permanece fijo en `00`, evidenciando visualmente que ambos contadores son independientes. Después, a partir de aproximadamente 2 µs, se aplica una ráfaga de `hit_pulse`, donde `hits` sube pasando por valores intermedios como `02` hasta saturarse también en `63` hacia el final de la simulación, sin que esto afecte en absoluto al valor ya saturado de `misses`. La señal `pulse_index` es interna del testbench y lleva el conteo total de pulsos generados a lo largo de la prueba (llegando a `0000006a`, es decir 106 en decimal). La señal `error_count` se mantiene en 0 durante toda la simulación, confirmando que ninguna comparación falló.

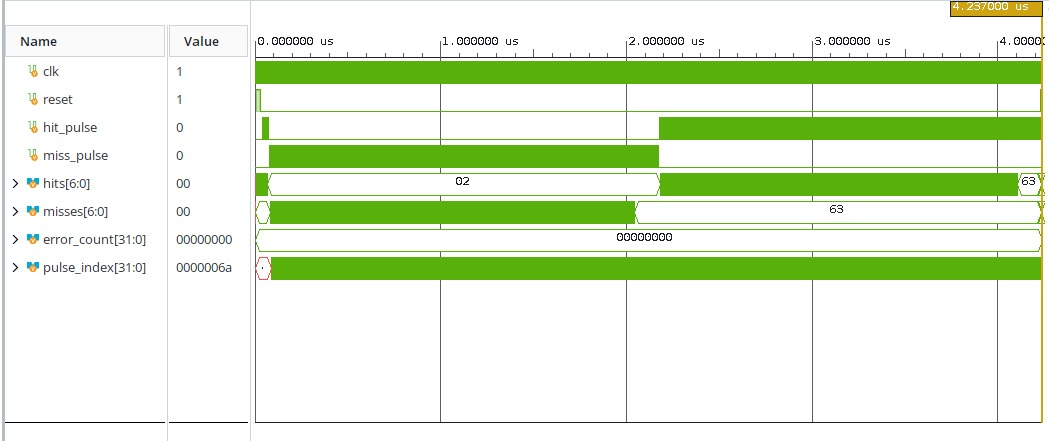
[picture p13: docs/informe/Imagenes/tb_scorecounter_2.jpeg]
Simulación score_counters 2


## 10. Análisis e interpretación de resultados

### 10.1 Análisis del LFSR

El LFSR de tres bits fue utilizado para generar las posiciones pseudoaleatorias del topo. Teóricamente, un LFSR máximo de tres bits puede recorrer siete estados diferentes antes de repetir la secuencia:

```text
Periodo máximo = 2^3 - 1 = 7 estados
```

El estado `000` queda excluido de la secuencia normal porque la operación XOR aplicada a bits iguales en cero produce nuevamente cero. Si el registro entra en `000`, la realimentación continúa siendo cero y el LFSR no puede abandonar este estado por sí mismo:

```text
Estado actual:       000
Realimentación XOR:    0
Estado siguiente:    000
```

Por esta razón, `000` se denomina estado absorbente o estado prohibido. En el circuito construido, `Q[2:0] = 000` también corresponde a la activación de `Y0` en el 74LS138 y, por tanto, al encendido de LED0. Esto provoca una ambigüedad: LED0 puede representar una posición válida desde el punto de vista del decodificador, pero también puede indicar que el LFSR quedó atrapado en su estado prohibido.

Durante las pruebas físicas se observó que, en algunas ocasiones, el circuito permanecía indefinidamente en LED0. La única forma inmediata de recuperar la secuencia era activar el reset propio del LFSR, el cual cargaba una semilla diferente de cero y colocaba el circuito nuevamente en LED1.

La secuencia teórica debe compararse con los estados medidos directamente en `Q2`, `Q1` y `Q0`. Para realizar una comparación correcta no basta con observar los LED, debido a que las salidas del 74LS138 son activas en bajo. La medición debe registrar el estado binario del LFSR después de cada flanco válido de solicitud.

| Aspecto | Comportamiento teórico | Comportamiento observado |
| --- | --- | --- |
| Cantidad máxima de estados no nulos | 7 | Se observaron diferentes posiciones antes de repetirse |
| Estado `000` | Debe excluirse de la secuencia | En algunas pruebas se presentó como bloqueo en LED0 |
| Semilla | Debe ser diferente de `000` | El reset del LFSR lo colocaba en LED1 |
| Avance | Un estado por cada solicitud válida | Funcionó cuando el pulso llegó correctamente |
| Repetición | Después de siete estados para un LFSR máximo | Debe verificarse experimentalmente con la tabla completa |
| Recuperación ante bloqueo | Carga de una semilla no nula | Se realizó manualmente mediante reset |

También se observó una detención aparente cuando se alcanzaba LED1. Sin embargo, las pruebas de diagnóstico indicaron que este comportamiento no era necesariamente un bloqueo interno del estado `001`. Cuando se aplicaba manualmente un pulso al circuito discreto, el LFSR avanzaba y el juego continuaba conservando el puntaje. Además, los LED de diagnóstico de la FPGA mostraban que la máquina de estados permanecía en `WAIT_POSITION`.

Esto permite concluir que, en el caso de LED1, la FPGA estaba esperando una nueva posición y que la solicitud automática no había sido reconocida correctamente por el circuito discreto. Por tanto, se deben separar los dos problemas:

- El bloqueo en LED0 es compatible con el estado absorbente `000` del LFSR.
- La detención en LED1 se relaciona principalmente con la generación, adaptación o detección de `SOLICITUD_TOPO`, y no con que `001` sea un estado prohibido.

Las soluciones recomendadas para el LFSR son:

1. Cargar siempre una semilla diferente de `000` durante el reset.
2. Detectar el estado `000` y sustituirlo automáticamente por una semilla válida.
3. Revisar los taps para garantizar un polinomio de periodo máximo.
4. Evitar utilizar `000` como una posición normal si el mismo valor representa el estado prohibido.
5. Verificar experimentalmente la secuencia completa mediante mediciones de `Q[2:0]`.
6. Incorporar un circuito de recuperación automática en lugar de depender de un reset manual.

Una posible protección puede expresarse conceptualmente como:

```systemverilog
if (reset || lfsr_state == 3'b000)
    lfsr_state <= 3'b001;
else
    lfsr_state <= next_lfsr_state;
```

Esta modificación impediría que el circuito permaneciera indefinidamente en `000`.

### 10.2 Análisis de comunicación

#### Comunicación UART

La arquitectura original requería una comunicación UART asíncrona con trama 8N1. Para cumplir esta parte se desarrollaron los módulos `uart_synchronizer`, `uart_rx` y `uart_test_led`.

El sincronizador de dos etapas reducía el riesgo de metastabilidad de la entrada serial. El receptor UART detectaba el bit de inicio, esperaba hasta el centro de cada bit, recibía ocho bits en orden LSB-first y verificaba el bit de parada. Finalmente, `uart_test_led` utilizaba los tres bits menos significativos del byte recibido para representar la posición mediante LED.

Las simulaciones funcionales demostraron que la lógica UART podía recibir correctamente valores como:

```text
0x05 -> posición 5
0x03 -> posición 3
0x07 -> posición 7
0x00 -> posición 0
```

La señal `data_valid` se activó al completar cada trama válida y el dato recibido se mantuvo estable. Esto demostró que el diseño lógico del receptor funcionaba bajo las condiciones ideales del testbench.

No obstante, durante la integración física la comunicación no se comportó de manera estable. Entre las posibles causas se encuentran:

- Diferencia entre la frecuencia real del transmisor discreto y la frecuencia configurada en la FPGA.
- Error acumulado en la duración de los bits.
- Forma de onda degradada por conexiones largas en protoboard.
- Ruido o transiciones lentas en la línea serial.
- Incompatibilidad de niveles entre lógica de 5 V y entradas de 3.3 V.
- Errores en la generación del bit de inicio, datos o bit de parada.
- Muestreo fuera del centro del bit.
- Ausencia de una referencia temporal suficientemente precisa en el transmisor discreto.

No se obtuvo evidencia suficiente para atribuir la falla a una única causa. Sin embargo, la simulación permitió determinar que el receptor funcionaba correctamente con una trama ideal, mientras que el problema aparecía al conectar el transmisor físico.

#### Sustitución mediante bus paralelo

Debido al tiempo disponible para completar la integración, se sustituyó el enlace UART por un bus paralelo de tres bits:

```text
Q0 -> position_async[0]
Q1 -> position_async[1]
Q2 -> position_async[2]
```

Cada señal fue adaptada a un nivel seguro para la FPGA y posteriormente sincronizada mediante flip-flops. El módulo `parallel_position_receiver` verificó que la posición permaneciera estable antes de entregarla a la máquina de estados.

Las principales ventajas del bus paralelo fueron:

- Implementación física más sencilla.
- Observación directa de cada bit con multímetro o LED.
- Eliminación de la dependencia del baud rate.
- Menor complejidad para detectar errores.
- Recepción inmediata de la posición.
- Mayor facilidad para probar independientemente el LFSR y la FPGA.

Sus principales limitaciones fueron:

- Utilización de tres líneas de datos en lugar de una.
- Necesidad de adaptar eléctricamente cada línea.
- Ausencia de una trama con bits de inicio y parada.
- Menor escalabilidad para transmitir datos de mayor tamaño.
- Posibilidad de recibir una combinación transitoria si los bits no cambian simultáneamente.
- Desviación respecto al requisito explícito de comunicación UART.

La sincronización de dos etapas reduce la metastabilidad, pero no garantiza por sí sola que los tres bits pertenezcan al mismo estado durante una transición. Por esta razón se incorporó una validación de estabilidad antes de aceptar una posición nueva.

#### Consecuencias sobre la rúbrica

La sustitución del enlace UART permitió completar y demostrar el funcionamiento general del juego, incluyendo generación de posiciones, lectura de botones, evaluación de golpes, temporización, dificultad, conteo y finalización de la partida.

Sin embargo, el bus paralelo no cumple literalmente el requisito de comunicación UART 8N1 indicado en el instructivo. Por tanto, esta modificación debe declararse como una limitación y puede producir una reducción en la calificación correspondiente a comunicación e integración.

Los módulos UART, sus testbenches y sus resultados de simulación demuestran que el protocolo fue estudiado e implementado digitalmente. Aun así, no debe afirmarse que la comunicación UART quedó completamente implementada, porque no se consiguió una operación física estable entre ambos subsistemas.

### 10.3 Análisis de la FPGA

Los módulos fueron evaluados inicialmente mediante testbenches individuales. Esta estrategia permitió comprobar cada función antes de integrarla con el resto del sistema.

Entre las pruebas realizadas se verificaron:

- Generación de `ce_1ms`.
- Sincronización y validación de la posición paralela.
- Antirrebote y generación de un pulso por botón.
- Evaluación de aciertos y fallos.
- Temporización de la ventana de juego.
- Reducción de la duración después de cada acierto.
- Conteo de aciertos y fallos acumulados.
- Reinicio de fallos consecutivos después de un acierto.
- Detección de tres fallos consecutivos.
- Transiciones de la FSM.
- Multiplexación de los displays.
- Comportamiento del LED de estado.
- Funcionamiento integral del módulo superior.

La simulación del módulo superior confirmó los siguientes comportamientos:

```text
PASS: La posición 2 enciende LED2
PASS: Botón correcto incrementa aciertos
PASS: Acierto reduce la duración del turno
PASS: Botón incorrecto cuenta fallo consecutivo
PASS: Acierto reinicia fallos consecutivos
PASS: Timeout cuenta como fallo
PASS: Tres fallos consecutivos producen game over
PASS: Indicador de estado permanece definido
PASS: Auto reset limpia ambos puntajes
PASS: Auto reset restaura dificultad inicial
PASS: tb_whack_a_mole_top completo sin errores
```

Posteriormente se modificó el comportamiento final para que el juego permaneciera en `game over` hasta recibir un reset general, de acuerdo con la decisión tomada durante las pruebas físicas. Esta diferencia debe reflejarse en el testbench final si se conserva dicha versión del controlador.

El diseño completó correctamente las etapas de síntesis, implementación y generación del bitstream. Esto demuestra que las construcciones de SystemVerilog utilizadas fueron sintetizables y que Vivado pudo asignarlas a los recursos de la FPGA.

No se utilizaron relojes generados mediante lógica común. El sistema trabaja con el reloj principal de 100 MHz y emplea señales de habilitación, como `ce_1ms`, para ejecutar operaciones lentas. Esta decisión mantiene un único dominio de reloj y simplifica el análisis temporal.

Los bloques secuenciales fueron descritos mediante `always_ff` y asignaciones no bloqueantes. Las decisiones combinacionales, particularmente la lógica de siguiente estado de la FSM, asignan valores predeterminados antes de evaluar las condiciones. Esto evita conservar valores accidentalmente y reduce el riesgo de inferir latches.

La validación temporal debe respaldarse con el reporte de timing de Vivado. No es suficiente que la generación del bitstream termine correctamente; para afirmar que el diseño cumple timing debe verificarse que el peor margen temporal sea no negativo:

```text
WNS >= 0 ns
TNS = 0 ns
```

Si estos valores aparecen en el reporte final, puede afirmarse que el diseño satisface las restricciones del reloj de 100 MHz. Los valores exactos de WNS y TNS deben copiarse del resumen de temporización de la implementación.

En las pruebas físicas, la FPGA respondió correctamente a los botones, actualizó los displays, redujo la duración de los turnos y detectó tres fallos consecutivos. Los principales problemas observados no se originaron en los contadores ni en la lógica de evaluación, sino en la interfaz con el circuito discreto: niveles eléctricos, generación de solicitudes y bloqueo del LFSR.

Los LED de diagnóstico permitieron observar señales internas importantes:

- Solicitud activa.
- Generador de solicitud ocupado.
- Solicitud pendiente.
- Estado actual de la FSM.

Cuando solamente `LD11` permanecía encendido, el código mostrado por los LED de estado era:

```text
FSM = 0001 = WAIT_POSITION
```

Esto demostró que la FPGA no estaba congelada. La máquina de estados funcionaba y esperaba que el receptor validara una nueva posición.

### 10.4 Problemas y soluciones

| Problema | Causa probable | Diagnóstico realizado | Solución aplicada o recomendada |
| --- | --- | --- | --- |
| UART inestable | Diferencias de temporización, señal física degradada o incompatibilidad de niveles | El receptor funcionó en simulación con tramas ideales, pero no de forma estable con el transmisor discreto | Se utilizó temporalmente un enlace paralelo `Q[2:0]`; como solución definitiva se recomienda medir la trama con osciloscopio y ajustar el transmisor UART |
| Solicitud perdida | Una nueva orden podía aparecer mientras el generador mantenía un pulso activo | LED de `busy`, solicitud y estado de la FSM | Se agregó una solicitud pendiente de profundidad uno y un intervalo bajo entre pulsos |
| Bloqueo en LED0 | Entrada del LFSR al estado absorbente `000` | LED0 permanecía activo y el reset del LFSR recuperaba la secuencia | Cargar una semilla no nula y detectar automáticamente `000` para reemplazarlo por `001` |
| Detención en LED1 | El circuito discreto no reconocía una nueva solicitud automática | La FSM permanecía en `WAIT_POSITION`; un pulso manual hacía avanzar el LFSR sin perder el puntaje | Revisar el ancho, polaridad y nivel del pulso; verificar el 2N2222 y agregar detección robusta de flanco en el circuito discreto |
| Niveles de 5 V | Incompatibilidad con entradas LVCMOS33 de la FPGA | Medición de aproximadamente 3.7 V y 5 V con multímetro | Utilizar divisores resistivos para `Q[2:0]`, tierra común y transistor 2N2222 para `SOLICITUD_TOPO` |
| Rebote de botones | Transiciones mecánicas múltiples durante una sola pulsación | Una pulsación podía interpretarse como varios eventos sin filtrado | Sincronización, muestreo cada 1 ms, validación durante 10 ms y generación de un pulso único |
| Cambio transitorio en `Q[2:0]` | Los tres bits pueden no llegar exactamente al mismo tiempo | Posibilidad de observar valores intermedios durante el cambio de posición | Sincronizador de dos etapas y validación de estabilidad antes de aceptar el dato |
| Juego detenido después de una posición | La FSM esperaba un dato nuevo que nunca fue validado | Estado `WAIT_POSITION` visible mediante `LD11`–`LD14` | Verificar que cada solicitud produzca un cambio real y reconocible en `Q[2:0]` |
| Pérdida del puntaje al recuperar el LFSR | Se utilizaba el reset general para salir del bloqueo | El reset general limpiaba contadores, dificultad y estado | Separar el reset del LFSR del reset general o incorporar recuperación automática del estado prohibido |
| Finalización automática no deseada | El diseño inicial incluía un temporizador de game over de 2 s | Después de finalizar, el sistema podía comenzar otra partida automáticamente | Modificar la FSM para permanecer en `game over` hasta recibir el reset general |

### 10.5 Interpretación general

Los resultados demuestran que la arquitectura modular de la FPGA funcionó correctamente tanto en las simulaciones unitarias como en la simulación integral. El sistema fue capaz de recibir posiciones, detectar botones, evaluar jugadas, modificar la dificultad, controlar los puntajes y finalizar la partida después de tres fallos consecutivos.

Las dificultades principales aparecieron en la interacción entre dos tecnologías con características diferentes: lógica TTL de 5 V en protoboard y lógica LVCMOS de 3.3 V en la FPGA. Los problemas de nivel, temporización y reconocimiento de pulsos no siempre se manifestaron en simulación, porque los testbenches utilizan señales ideales.

La prueba más importante para separar las posibles causas consistió en avanzar manualmente el LFSR mientras la FSM permanecía en `WAIT_POSITION`. Como el juego continuó sin perder el puntaje, se comprobó que la lógica principal de la FPGA seguía funcionando y que la detención se encontraba en la ruta de solicitud o en su reconocimiento por el circuito discreto.
---

## 11. Conclusiones

1. Se desarrolló un sistema digital modular para controlar un juego Whack-a-Mole utilizando una FPGA Nexys 4 y un subsistema de lógica discreta. La división en módulos independientes facilitó el diseño, la simulación, la integración y el diagnóstico de errores.

2. La lógica implementada en la FPGA permitió recibir la posición del topo, filtrar los ocho botones externos, evaluar aciertos y fallos, controlar la ventana temporal de cada turno, modificar progresivamente la dificultad y mostrar los puntajes en los displays de siete segmentos.

3. Los testbenches individuales permitieron verificar los módulos antes de realizar la integración. La simulación del módulo superior confirmó el conteo de aciertos y fallos, la reducción del tiempo por acierto, el reinicio de fallos consecutivos después de una respuesta correcta y la finalización de la partida después de tres fallos consecutivos.

4. El diseño completó correctamente las etapas de síntesis, implementación y generación del bitstream en Vivado 2026.1. Las pruebas físicas confirmaron que la FPGA reconocía los botones, mostraba la posición recibida, actualizaba los puntajes y controlaba la secuencia general del juego.

5. El uso de una señal de habilitación cada milisegundo permitió mantener todo el sistema dentro del dominio del reloj principal de 100 MHz. Esta decisión evitó generar relojes secundarios mediante lógica común y simplificó la sincronización de los módulos temporales.

6. El LFSR discreto generó diferentes posiciones para el topo; sin embargo, presentó una limitación importante asociada al estado `000`. Este estado puede ser absorbente y mantener permanentemente activa la posición LED0. La solución recomendada consiste en cargar siempre una semilla no nula y detectar automáticamente `000` para sustituirlo por un estado válido.

7. La detención observada en LED1 no correspondió necesariamente a un estado prohibido del LFSR. Los LED de diagnóstico mostraron que la FPGA permanecía en `WAIT_POSITION`, y al aplicar una solicitud manual el juego continuaba sin perder el puntaje. Esto indicó que el problema estaba relacionado principalmente con el reconocimiento físico de `SOLICITUD_TOPO`.

8. Se desarrollaron y simularon módulos para la recepción UART 8N1. Las simulaciones demostraron la recepción correcta de diferentes bytes bajo condiciones ideales. No obstante, la comunicación UART no presentó un funcionamiento físico suficientemente estable durante la integración entre la lógica discreta y la FPGA.

9. Para completar el funcionamiento del prototipo, la comunicación UART fue sustituida por un bus paralelo de tres bits `Q[2:0]`. Esta modificación facilitó la integración y permitió demostrar las funciones principales del juego, pero constituye una desviación explícita del requisito de comunicación establecido en el instructivo y puede afectar la evaluación correspondiente a este apartado.

10. La integración de circuitos TTL alimentados con 5 V y una FPGA con entradas de 3.3 V requirió medidas de protección. Los divisores resistivos, la tierra común y el transistor 2N2222 permitieron adaptar las señales y evitar la aplicación directa de tensiones inseguras sobre los pines Pmod.

11. Los LED de diagnóstico resultaron fundamentales durante las pruebas físicas. Mediante ellos fue posible distinguir entre un bloqueo de la FPGA, una espera válida de la máquina de estados y una solicitud no reconocida por el circuito discreto.

12. Como mejoras futuras se propone corregir definitivamente la secuencia del LFSR, incorporar recuperación automática del estado `000`, robustecer la detección de `SOLICITUD_TOPO`, medir las señales con osciloscopio o analizador lógico y completar la comunicación UART física conforme al protocolo requerido.

En términos generales, el proyecto permitió aplicar conceptos de lógica combinacional y secuencial, registros, LFSR, máquinas de estados, sincronización, antirrebote, temporización, comunicación digital y multiplexación de displays. Aunque permanecieron limitaciones en el LFSR y en la comunicación UART, la implementación obtenida demostró el funcionamiento modular de la FPGA y permitió identificar con evidencia las mejoras necesarias para alcanzar el cumplimiento completo de las especificaciones.

---
