IE-TDD-EL3313/Proyecto_1/docs/informe/Imagenes/tb_difficultycontroller_2.jpeg

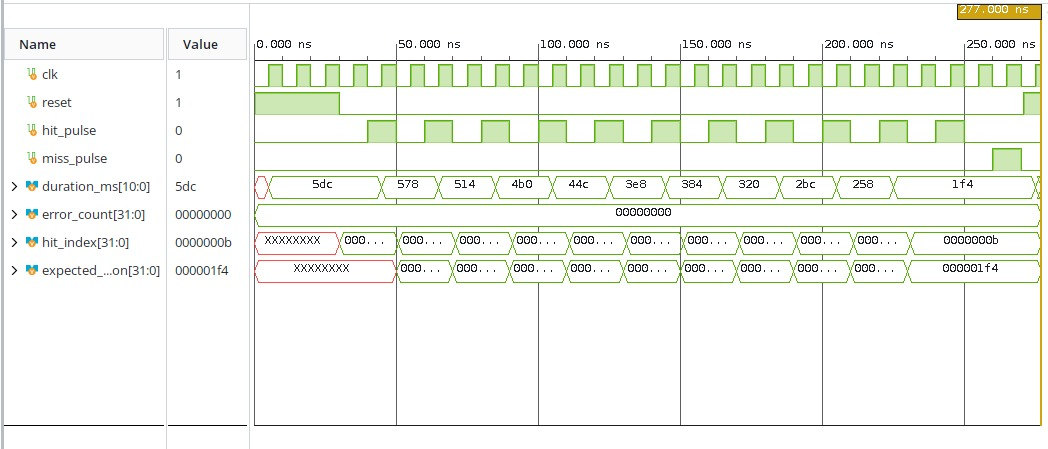
docs/informe/Imagenes/tb_difficultycontroller_2.jpeg
