IE-TDD-EL3313/Proyecto_1/(commit log)

2026-08-13 Crear carpeta para documentos
2026-08-14 Update documentación diagrama de tercer nivel para el sistema discreto
2026-08-14 Create nose.md
    Carpeta de imagenes
2026-08-14 Agregando descripcion del diagrama de tercer nivel del subsistema de la fpga
    Expanded the third-level design section for the FPGA subsystem, detailing functional blocks and their responsibilities. Added descriptions for various blocks including UART receiver, synchronization, scoring, and display control.
2026-08-14 Agregando diagramas de cuarto nivel, bloque receptor
    Updated section titles and improved descriptions for the UART Receiver design documentation.
2026-08-18 Tabla de estados y Avance Circuito discreto
2026-08-18 Documentacion Gnerador de referencia temporal
2026-08-20 UART byte preparation and add frame packaging
    Updated section 5.2.7 to describe UART byte preparation and added section 5.2.8 for UART frame packaging.
2026-08-20 Implementacion de sincronizador UART de dos etapas
2026-08-20 Implementacion del receptor UART a una tasa de 2400 baud
2026-08-20 Implementacion del registro de posicion del topo
2026-08-20 Bloque completo del receptor UART y registro de posicion
2026-08-20 Implementacion completa del bloque evaluador de golpe
2026-08-20 actualizacion bloque registro/transmision uart
2026-08-20 Update diseño_inicial.md corrección de los errores anteriores para poder merge
2026-08-23 Document UART byte preparation and framing process
    Added section on UART byte preparation and framing.
2026-08-25 Agregando pruebas de botones, temporizadores y UART
2026-08-27 Agregar prueba de recepción paralela de posición
2026-08-27 Agregar prueba de botones externos con antirrebote
2026-08-27 Integracion de posición botones puntaje y displays
2026-08-27 Agregar base de tiempo de 1 ms y pruebas
2026-08-27 Agregar sincronizacion y antirrebote de botones
2026-08-27 Agregar enlace paralelo y solicitud de topo
2026-08-27 Agregar evaluador de golpes y temporizador de turno
2026-08-27 Agregar FSM principal y control de fin de partida
2026-08-27 Agregar displays de puntaje e indicador de estado
2026-08-27 Integrar juego final y asignaciones de la Nexys 4
2026-08-28 documentación de algunos módulos FPGA
2026-08-28 Agregando resumen, introduccion, objetivos, explicacion del uart en simulacion
    Updated the technical report for the Whack-a-Mole project, including detailed descriptions of the discrete logic and FPGA integration, communication methods, and project limitations. Added sections on system specifications, state machines, and display multiplexing.
2026-08-28 Evidencias y resultados de simulación
2026-08-28 Rename Captura desde 2026-08-27 22-18-04.png to uart_integrado.png
2026-08-28 Fix image path for UART simulation
    Updated image path for UART simulation in technical report.
2026-08-28 Actualizar informe con metodología y herramientas
    Se actualizó el informe técnico para mejorar la claridad y la estructura del contenido. Se añadieron detalles sobre la metodología de desarrollo y las herramientas utilizadas en el proyecto.
2026-08-28 Agregando arquitectura general implementada
    Updated the technical report to reflect changes in the architecture and gameplay flow. Added detailed explanations of the system's operation and the state machine's behavior.
2026-08-28 Enhance documentation for sync_2ff and button_debouncer
    Added detailed explanations for the `sync_2ff` and `button_debouncer` modules, including their interfaces, metastability, latency, and design decisions.
